ZUBA-projects/MINISUMO_ROBOT/README.md

# MINISUMO_ROBOT_EDU1

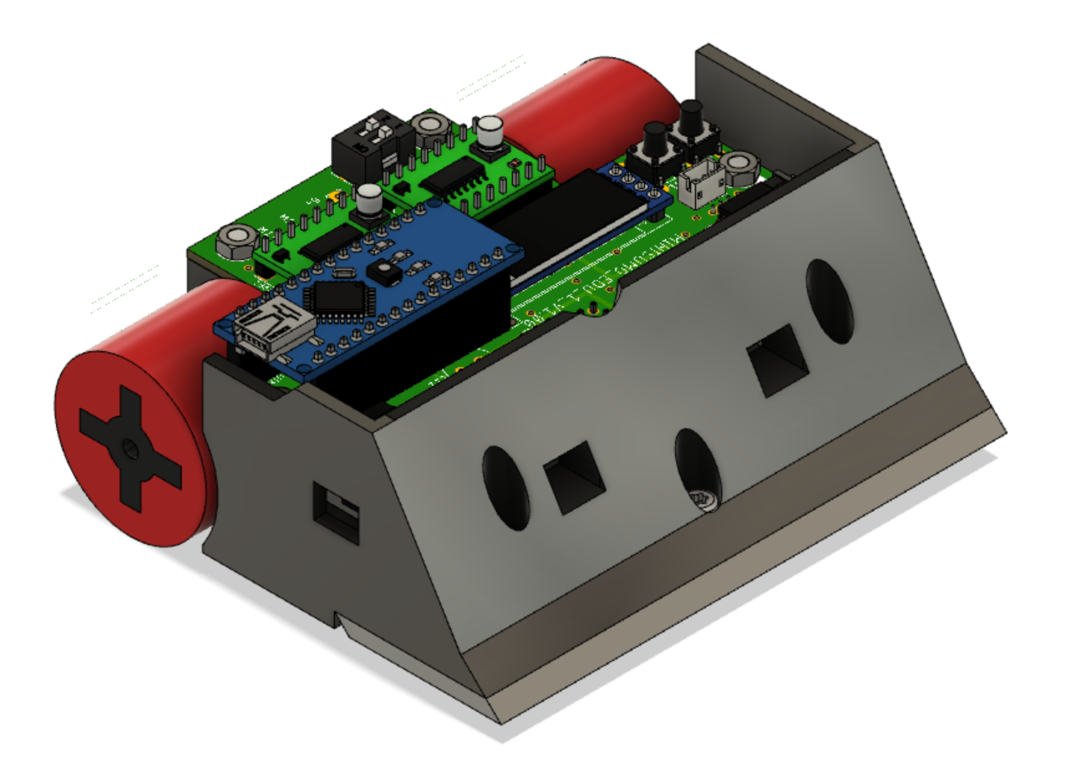
[picture p1: Minisumo_EDU_1/3D_projects/3D_EDU1_V1/MINISUMO_EDU_1.png]
Minisumo_EDU_1


Minisumo_EDU_1_done
