ZUBA-projects/MINISUMO_ROBOT/Minisumo_EDU_1/README.md

# MINISUMO_ROBOT_EDU1

Minisumo_EDU_1

There is project of Minisumo robot EDU1. 
There is two versions of hardware and 3D designs. Old one has some bugs. 
Version 2 of PCB and 3D files is fixed. Please base on fusion 360 files. 
Current design may contain bugs, errors and gluten. 

```
Hardware    -Eagle project files of hardware 
Software    -Software files (code sources)
3D_project  -Fusion360 3D project and STL files to print 
```

Assembly video PCB version 1.00, 3D design V1: https://www.youtube.com/watch?v=iEzcPpjPMYo

<object width="425" height="350">
  <param name="movie" value="https://www.youtube.com/watch?v=iEzcPpjPMYo" />
  <param name="wmode" value="transparent" />
  <embed src="https://www.youtube.com/watch?v=iEzcPpjPMYo"
         type="application/x-shockwave-flash"
         wmode="transparent" width="425" height="350" />
</object>

Minisumo_EDU_1
Minisumo_EDU_1
Minisumo_EDU_1
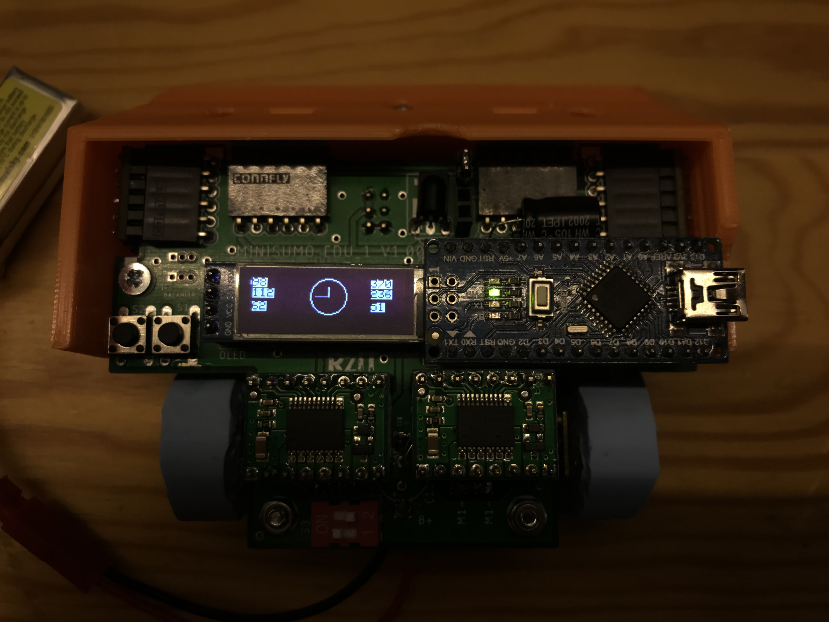
[picture p2: Minisumo_EDU_1/3D_projects/3D_EDU1_V1/Photo_7.jpg]
Minisumo_EDU_1

Minisumo_EDU_1
Minisumo_EDU_1

Enjoy!
