ZUBA-projects/MINISUMO_ROBOT/Minisumo_EDU_1/PCB_projects/README.md

# MINISUMO_ROBOT_EDU1

Mainboard rev 1.10
	
```
	//in future
```

Mainboard rev 1.00

```
Bugs: 
	-bad JST balancer connector size
	-bad color sensor connector pinout
```

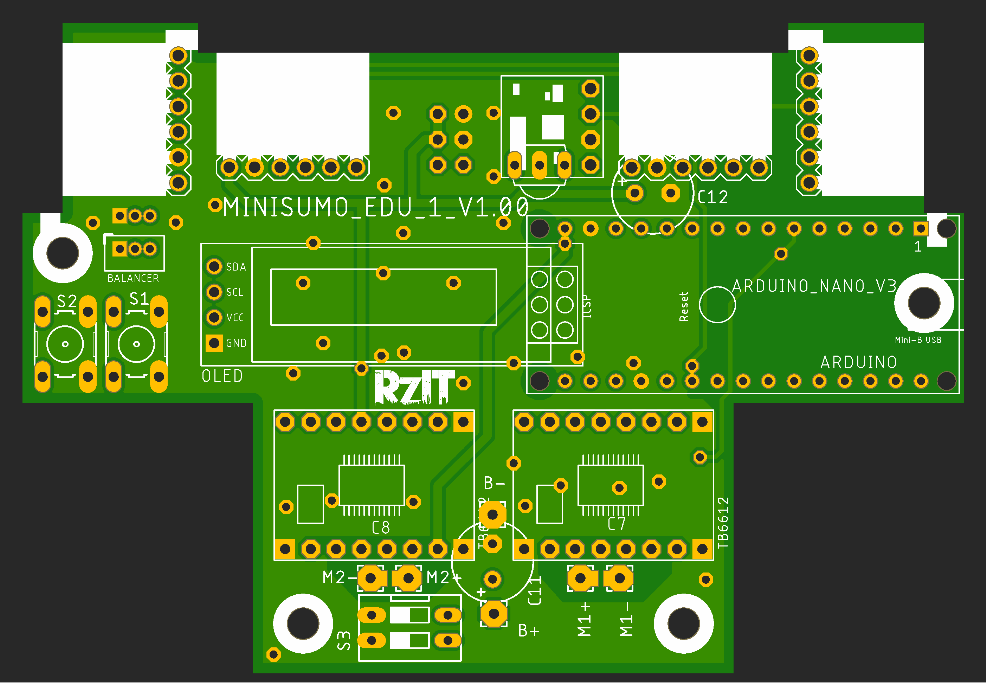
[picture p3: Minisumo_EDU_1/PCB_projects/PCB_Rev_1.00/Photo_0.png]
Minisumo_EDU_1

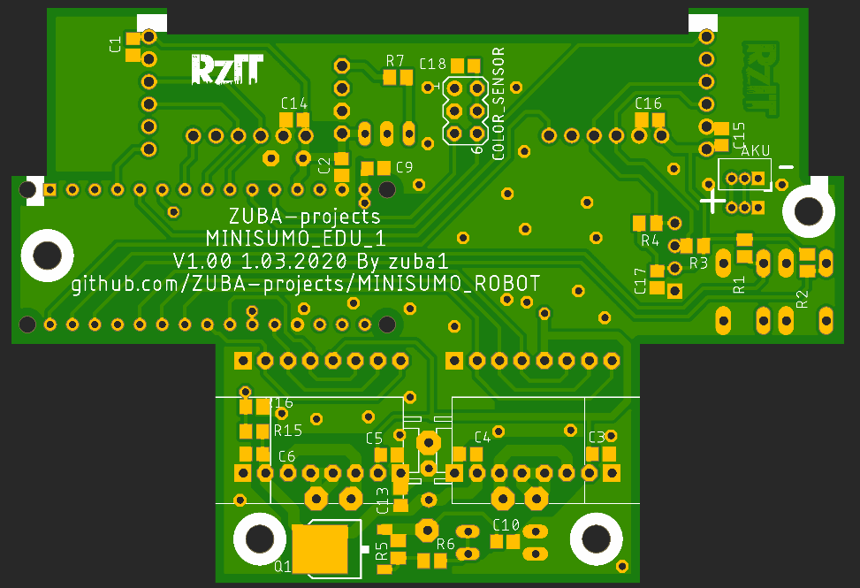
[picture p4: Minisumo_EDU_1/PCB_projects/PCB_Rev_1.00/Photo_1.png]
Minisumo_EDU_1


Eagle libraries file: https://github.com/ZUBA-projects/ZUBA_EAGLE_LBR
