ZUBA-projects/MINISUMO_ROBOT/Minisumo_EDU_1/3D_projects/README.md

# MINISUMO_ROBOT_EDU1

3D design files. Stl, Fusion files and photos of final minisumo robot.
Use EDU1_V2 files.

```
3D_EDU1_V1   -First version of robot 3D design. Contains some mechanical bugs
3D_EDU1_V2   -Second version of robot 3D design. Fixed mechanical bugs. (recommended)
3D_WHEEL_V1  -3d Model files of wheel. First version- not tested yet 
```

EDU1_V2 (recommended) 3d model:

EDU1_V1 (old) 3d model:

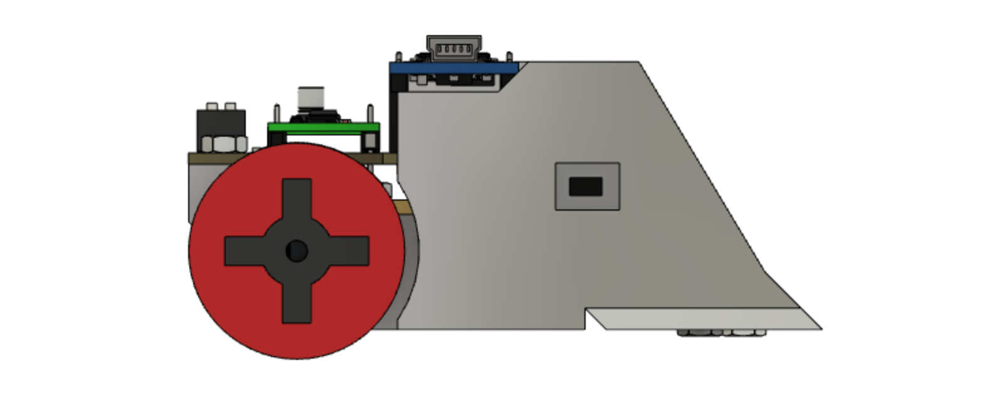
[picture p5: Minisumo_EDU_1/3D_projects/3D_EDU1_V1/Photo_1.png]
Minisumo_EDU_1

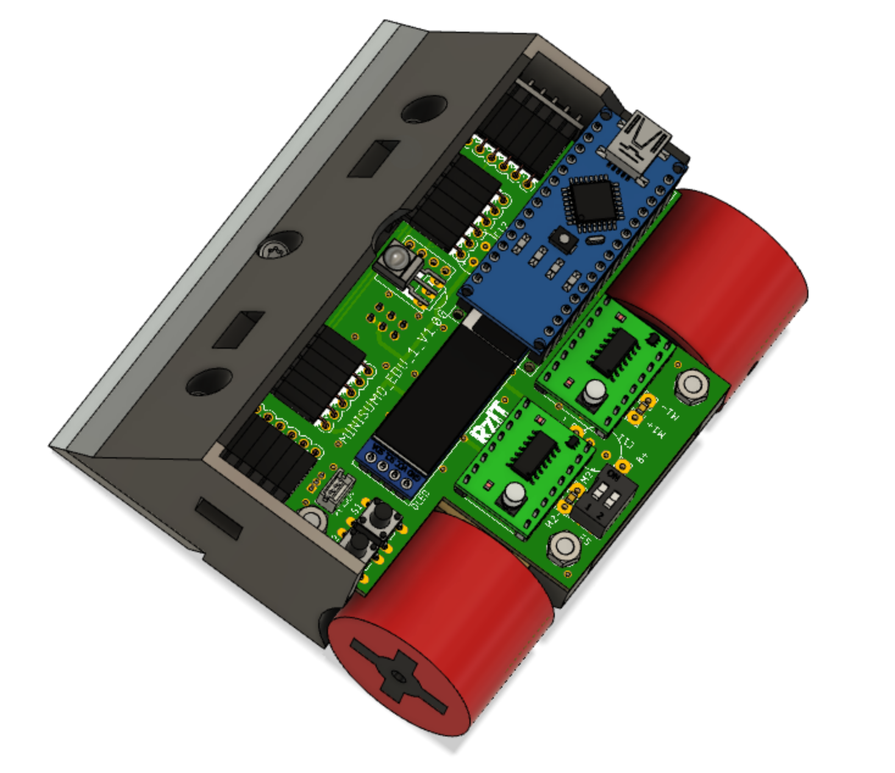
[picture p6: Minisumo_EDU_1/3D_projects/3D_EDU1_V1/Photo_2.png]
Minisumo_EDU_1

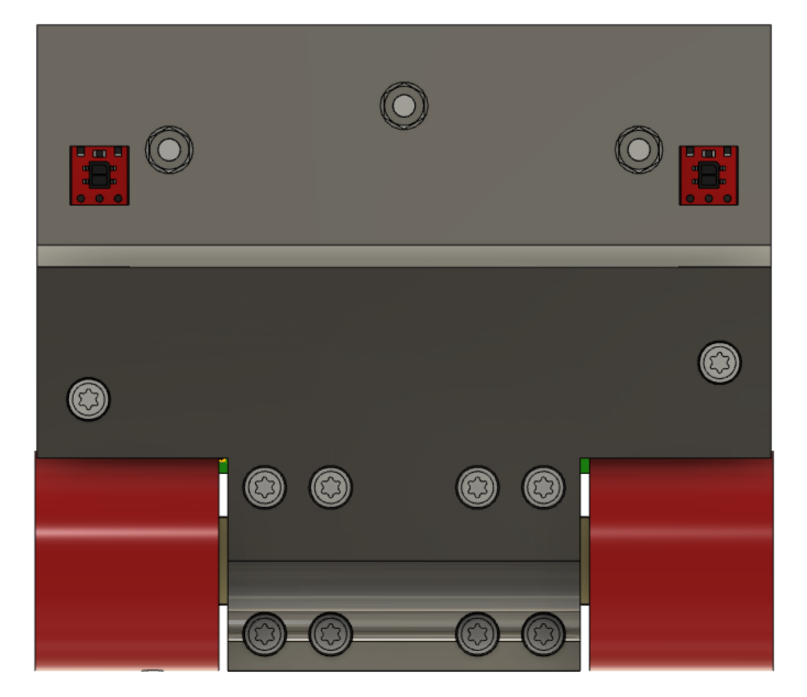
[picture p7: Minisumo_EDU_1/3D_projects/3D_EDU1_V1/Photo_3.png]
Minisumo_EDU_1

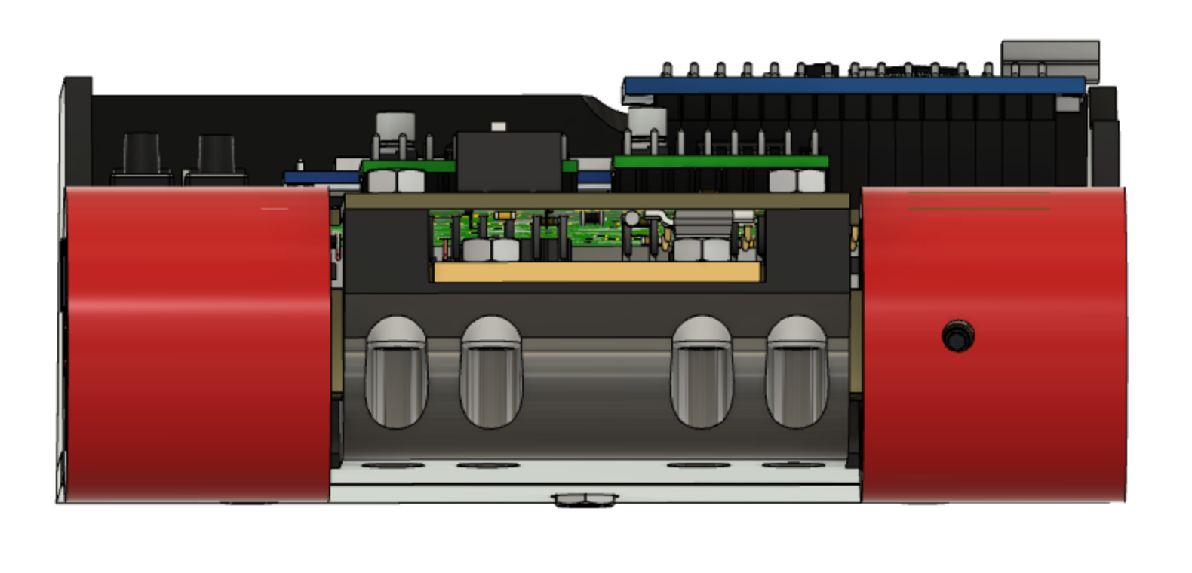
[picture p8: Minisumo_EDU_1/3D_projects/3D_EDU1_V1/Photo_4.png]
Minisumo_EDU_1


Create your own silicone Tire V1 step by step (video in future):

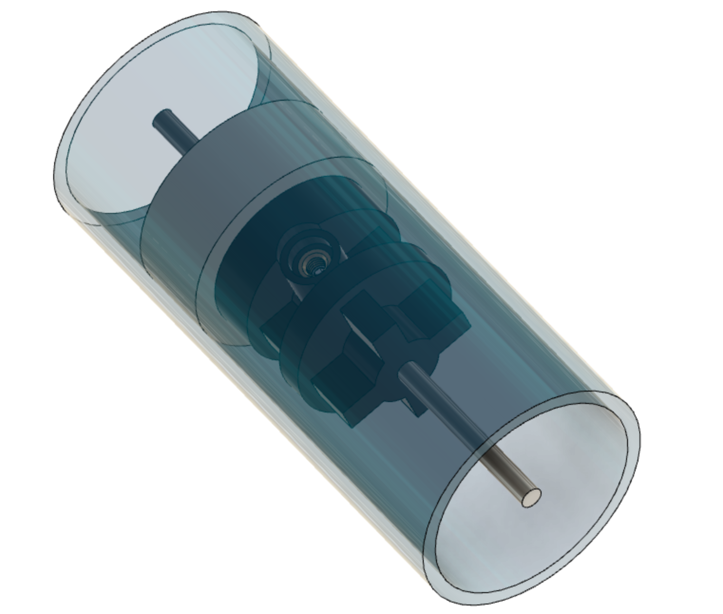
[picture p9: Minisumo_EDU_1/3D_projects/3D_WHEEL_V1/Photo_0.png]
Minisumo_EDU_1

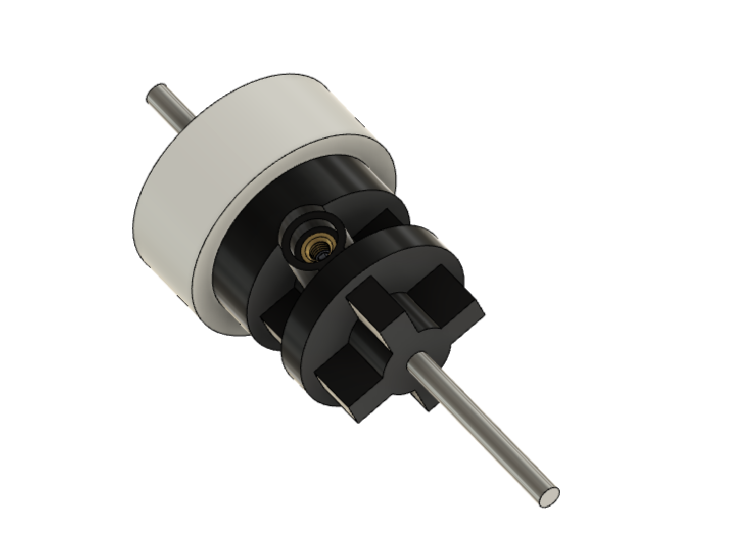
[picture p10: Minisumo_EDU_1/3D_projects/3D_WHEEL_V1/Photo_1.png]
Minisumo_EDU_1

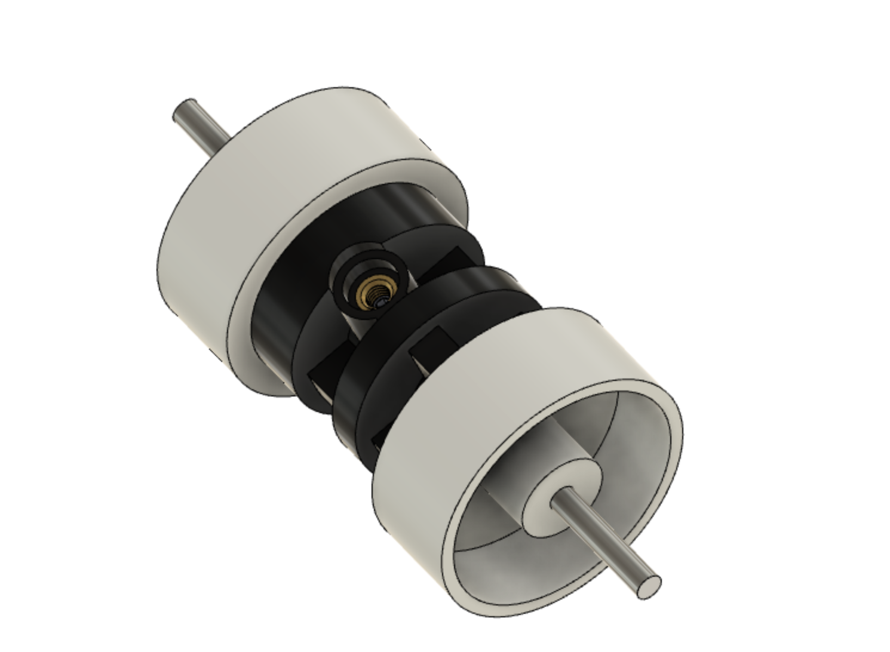
[picture p11: Minisumo_EDU_1/3D_projects/3D_WHEEL_V1/Photo_2.png]
Minisumo_EDU_1

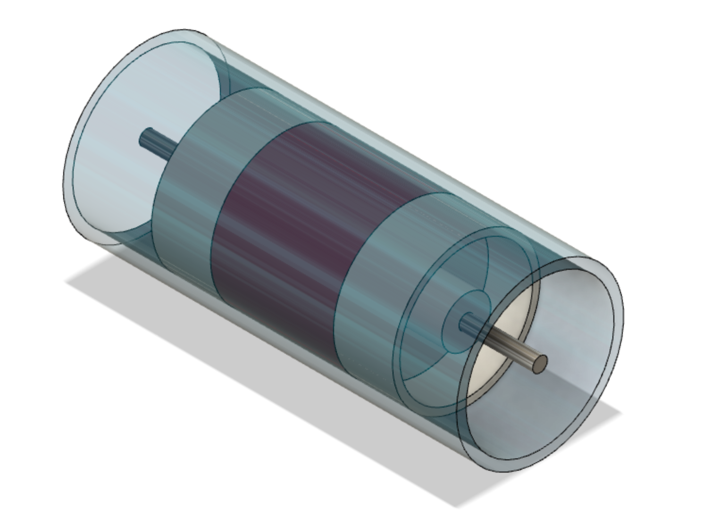
[picture p12: Minisumo_EDU_1/3D_projects/3D_WHEEL_V1/Photo_3.png]
Minisumo_EDU_1
