ZUBA-projects/MINISUMO_ROBOT/Minisumo_EDU_1/Software/README.md

# MINISUMO_ROBOT_EDU1 Software

This software is compatible witch all of main boards versions for EDU_1 robot. Right now the software is not finished yet. There is two versions of software. The miniOS will be supported by Arduino in future. 

Current version: 0.32

```
Arduino_example  -an example for test your hardware connection- Not finished, no longer supported.
Minisumo_EDU1    -miniOS HAL software port (OS designed for Minisumo robot) -still in development.
```
