ZUBA-projects/MINISUMO_ROBOT/Minisumo_EDU_1/PCB_projects/PCB_Rev_1.00/Minisumo_EDU_1_BOM.xlsx

Sheet: Mainboard_And_Sensors
Main board:
Qty | Value | Parts | Package | LINKS | Price for one | Price[PLN]
1 | 100R | R6 | M0805 | https://www.tme.eu/pl/details/smd0805-100r/rezystory-smd-0805/royal-ohm/0805s8j0101t5e/ | 0.05 | 0.05
1 | 1K | R16 | M0805 | https://www.tme.eu/pl/details/smd0805-1k/rezystory-smd-0805/royal-ohm/0805s8j0102t5e/ | 0.05 | 0.05
2 | 4K7 | R3, R4 | M0805 | https://www.tme.eu/pl/details/smd0805-4k7/rezystory-smd-0805/royal-ohm/0805s8j0472t5e/ | 0.05 | 0.1
4 | 10K | R1, R2, R5, R15 | M0805 | https://www.tme.eu/pl/details/crcw080510k0fktabc/rezystory-smd-0805/vishay/ | 0.05 | 0.2
16 | 100nF | C1, C2, C3, C4, C5, C6, C7, C8, C9, C10, C13, C14, C15, C16, C17, C18 | C0805 | https://www.tme.eu/pl/details/cl21b104kbcnnnc/kondensatory-mlcc-smd-0805/samsung/ | 0.084 | 1.344
2 | 47uF | C11, C12 | E3,5-8 | https://www.tme.eu/pl/details/ce-47_50pht/kondensatory-elektrolityczne-tht-105degc/samwha/rd1h476m6l011bb/ | 0.307 | 0.614
1 | IRFR5305 or similar | Q1 | D-PAK_TO252AA | https://www.tme.eu/pl/details/std46p4llf6/tranzystory-z-kanalem-p-smd/stmicroelectronics/ | 3.8 | 3.8
1 | TSOP4838 | U$2 | TSOP | https://www.tme.eu/pl/details/tsop4838/moduly-odbiorcze-ir/vishay/ | 2.21 | 2.21
1 | START_MODULE | U$12 | START_MODULE | https://p1r.se/startmodule/ | 0 | 0 | use this module if TSOP4838 is not used
1 | power switch | S3 | DS-02 | https://www.tme.eu/pl/details/ds-02/przelaczniki-typu-dip-switch/ninigi/ | 2.16 | 2.16
2 | function switch | S1, S2 | B3F-10XX | https://www.tme.eu/pl/details/evqpac09k/mikroprzelaczniki-tact/panasonic/ | 0.63 | 1.26
2 | JST_ZH_3 | AKU, BALANCER | JST_ZH_3 | https://www.tme.eu/pl/details/b3b-ph-k-s/zlacza-sygnalowe-raster-2-00mm/jst/ | 0.6 | 1.2
4 | VL53L0XCJ_2 | U$1, U$3, U$8, U$9 | Only Connector | https://www.tme.eu/pl/details/zl263-6sg/listwy-i-gniazda-kolkowe/connfly/ds1024-1-6rf1/ | 0.6 | 2.4
4 | VL53L0XCJ_2 | U$1, U$3, U$8, U$9 | VL53L0X_4 | http://pl.aliexpress.com/item/4000163323280.html | 13 | 52
4 | TB6612POLOLU | U$4, U$5 | Only Connector | https://www.tme.eu/pl/details/zl262-8sg/listwy-i-gniazda-kolkowe/connfly/ds1023-1-8s21/ | 0.35 | 1.4
2 | TB6612POLOLU | U$4, U$5 | POLOLU | https://www.tme.eu/pl/details/pololu-713/modulowe-sterowniki-silnikow/pololu/ | 16.43 | 32.86
1 | Color sensor conn | COLOR_SENSOR | MA03-2 | https://www.tme.eu/pl/details/pololu-2458/czujniki-odleglosci/pololu/qtr-1a-reflectance-sensor/ | 15.61 | 15.61
2 | ARDUINO_NANO_V3 | ARDUINO | Only Connector | https://www.tme.eu/pl/details/zl262-16sg/listwy-i-gniazda-kolkowe/connfly/ds1023-1-16s21/ | 0.72 | 1.44
1 | ARDUINO_NANO_V3 | ARDUINO | ARDUINO_NANO_V3 | http://pl.aliexpress.com/item/32323945639.html | 10 | 10
1 | OLED_128X32 | OLED | OLED | http://pl.aliexpress.com/item/32661842518.html | 6.42 | 6.42
1 | aku connector | B+ B- | LiPol connector | https://abc-rc.pl/product-pol-692-Wtyk-JST-BEC-z-przewodem-zenski-110mm-female.html | 1 | 1
1 | PCB | PCB |  |  | 10 | 10
 |  |  |  | price: |  | 146.118
and create charging cable:
 |  |  |  | https://www.tme.eu/pl/details/phr-3/zlacza-sygnalowe-raster-2-00mm/jst/
 |  |  |  | https://www.tme.eu/pl/details/sph-002t-p0.5s/zlacza-sygnalowe-raster-2-00mm/jst/

Sheet: Mechanical
Qty | Value | LINKS | Price[PLN]
1 | M3x6 | https://allegro.pl/oferta/sruba-kulista-m3-x-6-mm-m3x6-imbus-5-szt-7290781504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 | 2.13
4 | M3x8 | https://allegro.pl/oferta/metalowa-sruba-ampulowa-din-912-8-8-m3x8mm-10szt-7384599853 | 1.2
6 | M3x15 | https://allegro.pl/oferta/sruba-kulista-m3-x-16-mm-m3x16-imbus-5-szt-8518838451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 | 2.56
2 | M3x25 | https://allegro.pl/oferta/sruba-kulista-m3-x-25-mm-m3x25-imbus-5-szt-8844405132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 | 2.45
1 | Silicone | https://allegro.pl/oferta/profesjonalny-silikon-do-form-mm922-0-25kg-polecam-6730393238 | 28
1 | ALUMINIUM 2mm |  | 5
2 | INSERT 3mm | https://allegro.pl/oferta/insert-gwintowany-m3-7772653476 | 4
3 | SCREW M3 | https://allegro.pl/oferta/m3-x-5mm-sruba-dociskowa-imbusowa-bez-lba-e8950-8910342394 | 2
2 | POLOLU 30:1 MP or HP (or use N20) | https://allegro.pl/oferta/silnik-pololu-mp-30-1-8605570005 | 140
1 | KNIFE | https://allegro.pl/oferta/noz-do-strugarki-noze-heblarki-ds-ncv1-410x30x3-5894552908 | 34
 |  | Price: | 221.34

Sheet: TOTAL
Robot:
Qty | Link | Price[PLN]
Main Board And Sensors |  | 146.118
Mechanical |  | 221.34
Lipol 500mAh 7,4V JST | https://allegro.pl/oferta/bateria-li-po-7-4v-2s-500mah-20c-turnigy-rc-7442301257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 | 38
price: |  | 405.458
Aditional Cost:
Qty | Link | Price[PLN]
3d Printing |  | 25
Knife Miling |  | 30
Lipol Charger | https://allegro.pl/oferta/ladowarka-mikroprocesorowa-redox-alpha-v2-combo-8395806877 | 120
Charging cable |  | 5
Price: |  | 180
TOTAL: |  | 585.458
