ZUBA-projects/MINISUMO_ROBOT/Minisumo_EDU_1/3D_projects/3D_EDU1_V1/stl_files/Minisumo_Body.stl

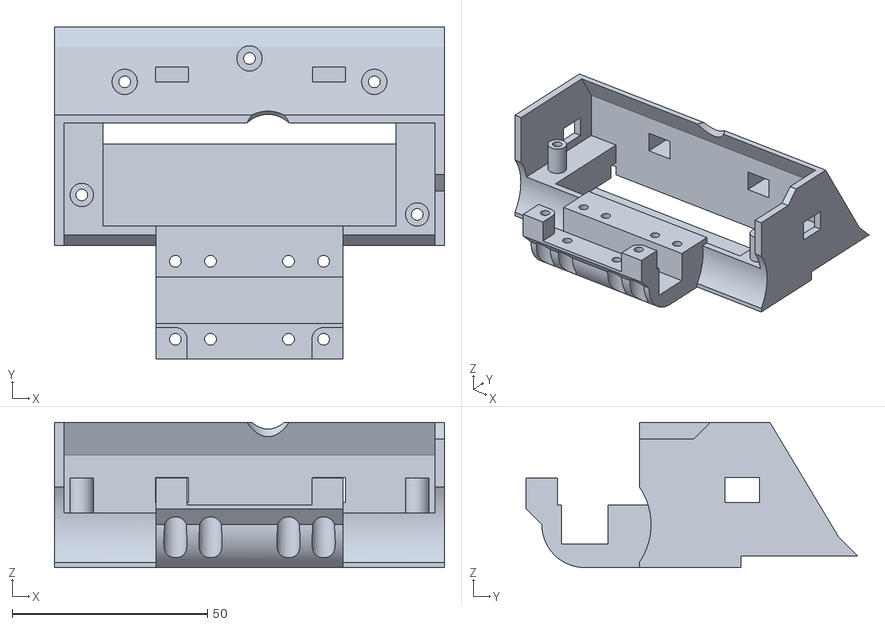
[picture p13: CAD file, 2020-03-08]
Minisumo_EDU_1/3D_projects/3D_EDU1_V1/stl_files/Minisumo_Body.stl
100.0 x 85.0 x 37.2
