ZUBA-projects/MINISUMO_ROBOT/Minisumo_EDU_1/3D_projects/3D_WHEEL_V1/stl_files/holedr_wheel.stl

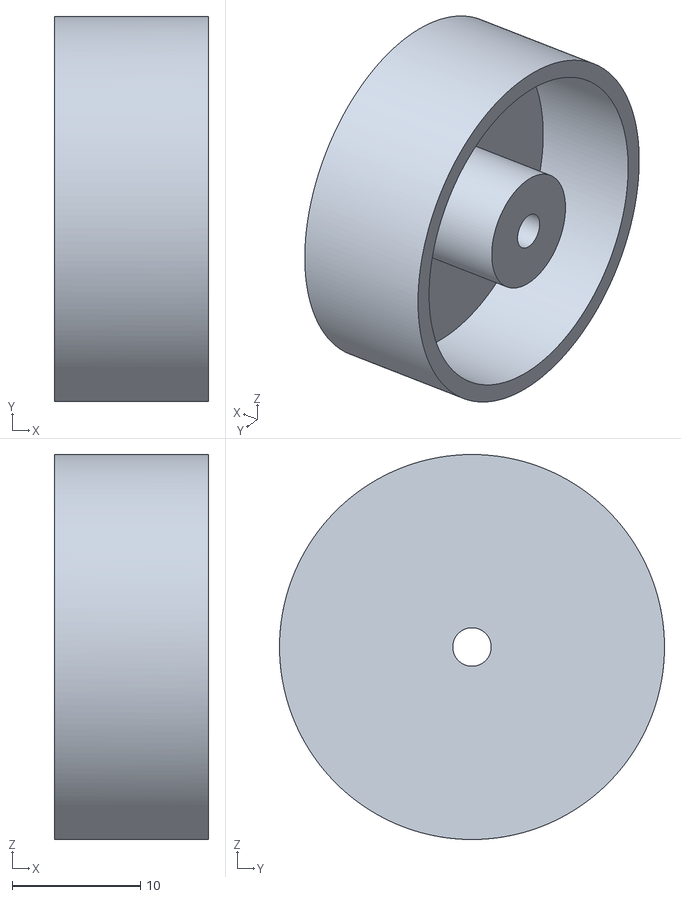
[picture p14: CAD file, 2020-03-08]
Minisumo_EDU_1/3D_projects/3D_WHEEL_V1/stl_files/holedr_wheel.stl
12.0 x 30.0 x 30.0
