ZUBA-projects/MINISUMO_ROBOT/Minisumo_EDU_1/3D_projects/3D_WHEEL_V1/stl_files/wheel.stl

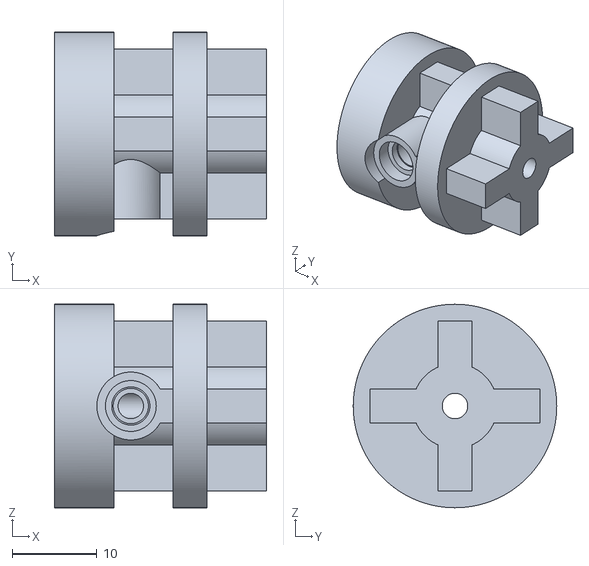
[picture p15: CAD file, 2020-03-08]
Minisumo_EDU_1/3D_projects/3D_WHEEL_V1/stl_files/wheel.stl
25.0 x 24.0 x 24.0
