ZUBA-projects/MINISUMO_ROBOT/(list of files, cad)

Other CAD files:
Minisumo_EDU_1/3D_projects/3D_WHEEL_V1/Wheel_30x25.f3d
