ZUBA-projects/MINISUMO_ROBOT/Minisumo_EDU_1/PCB_projects/PCB_Rev_1.00/main.pdf

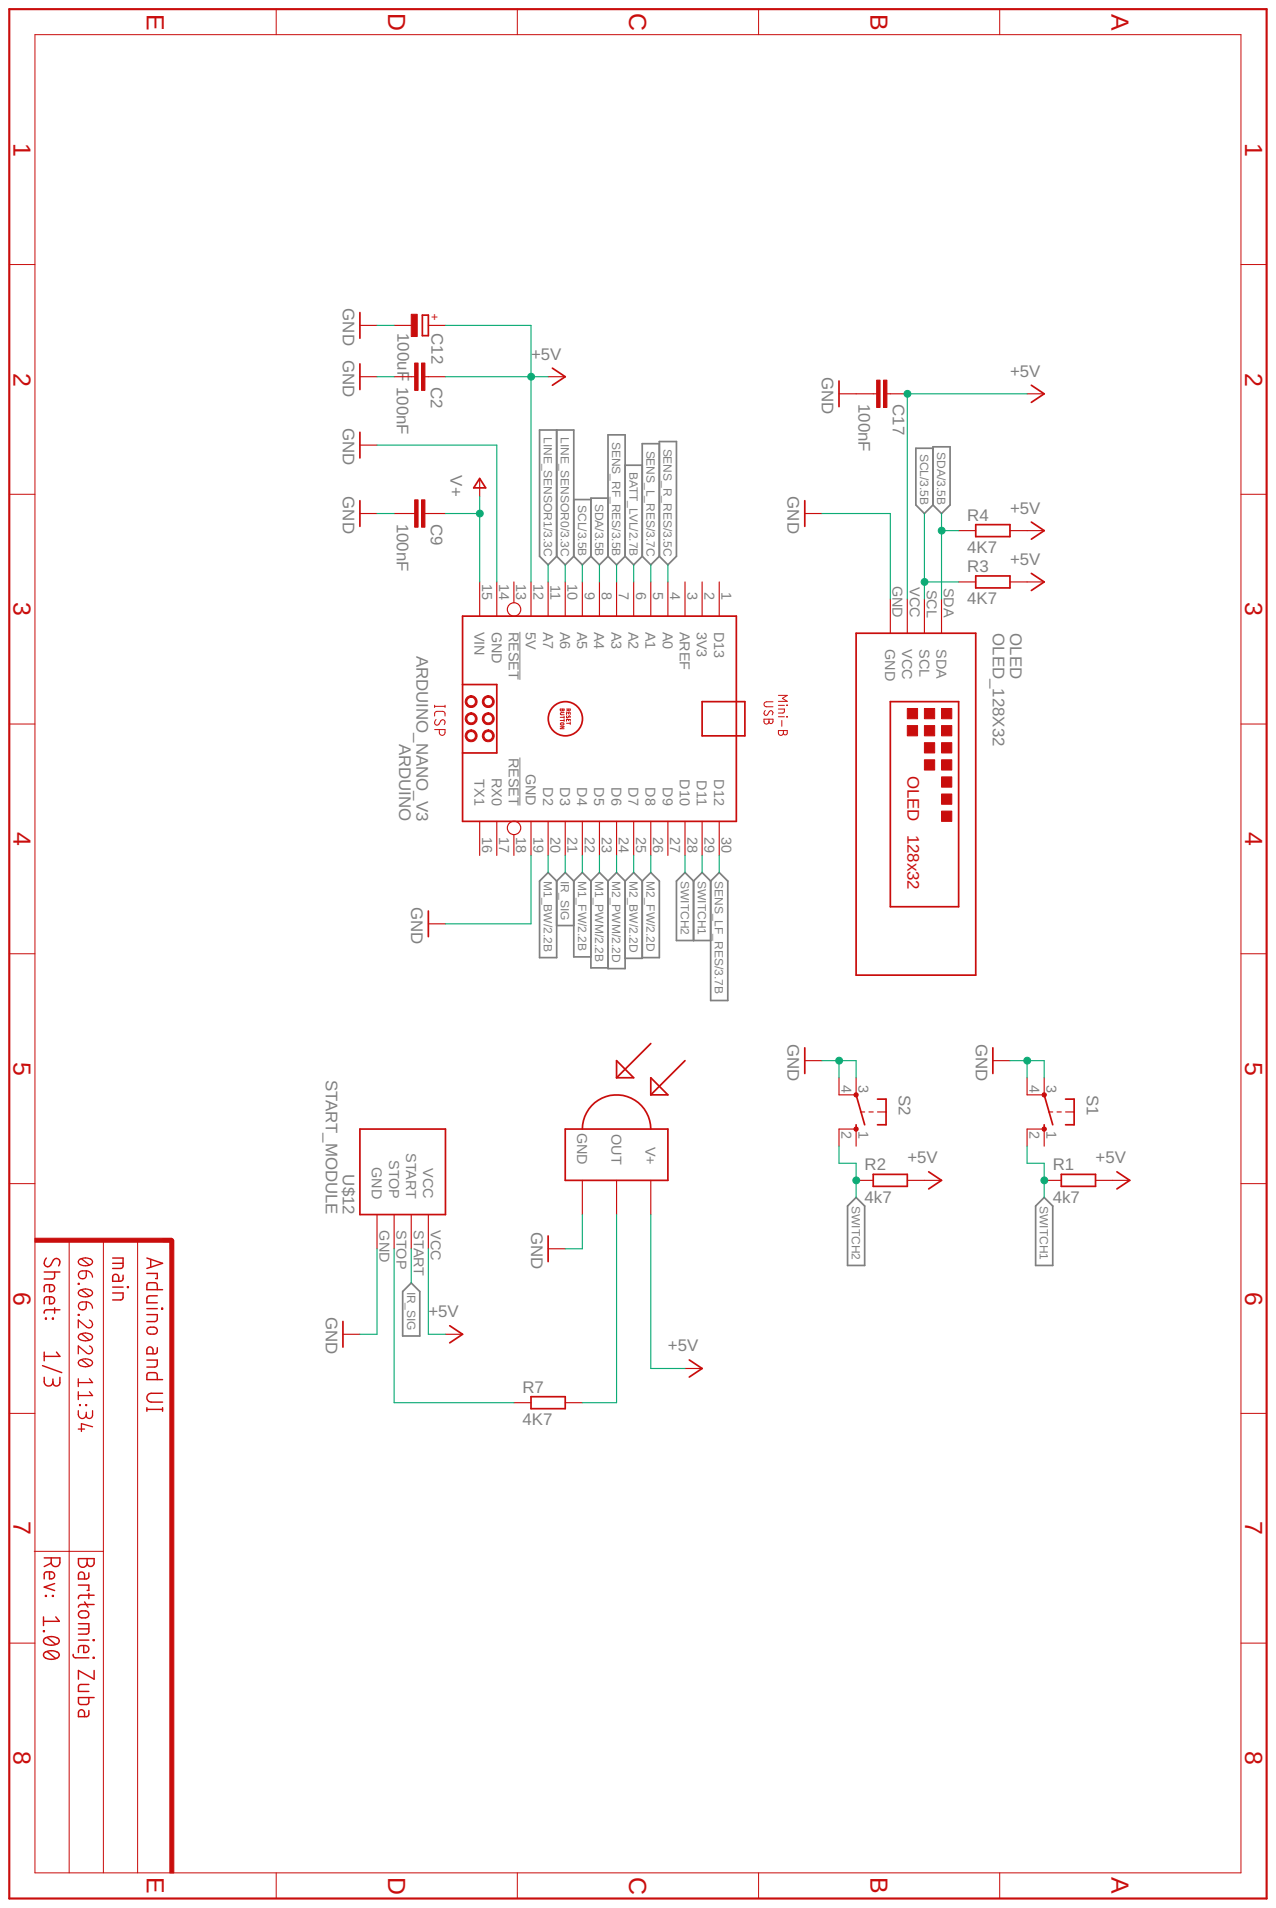
[picture p16: page 1]

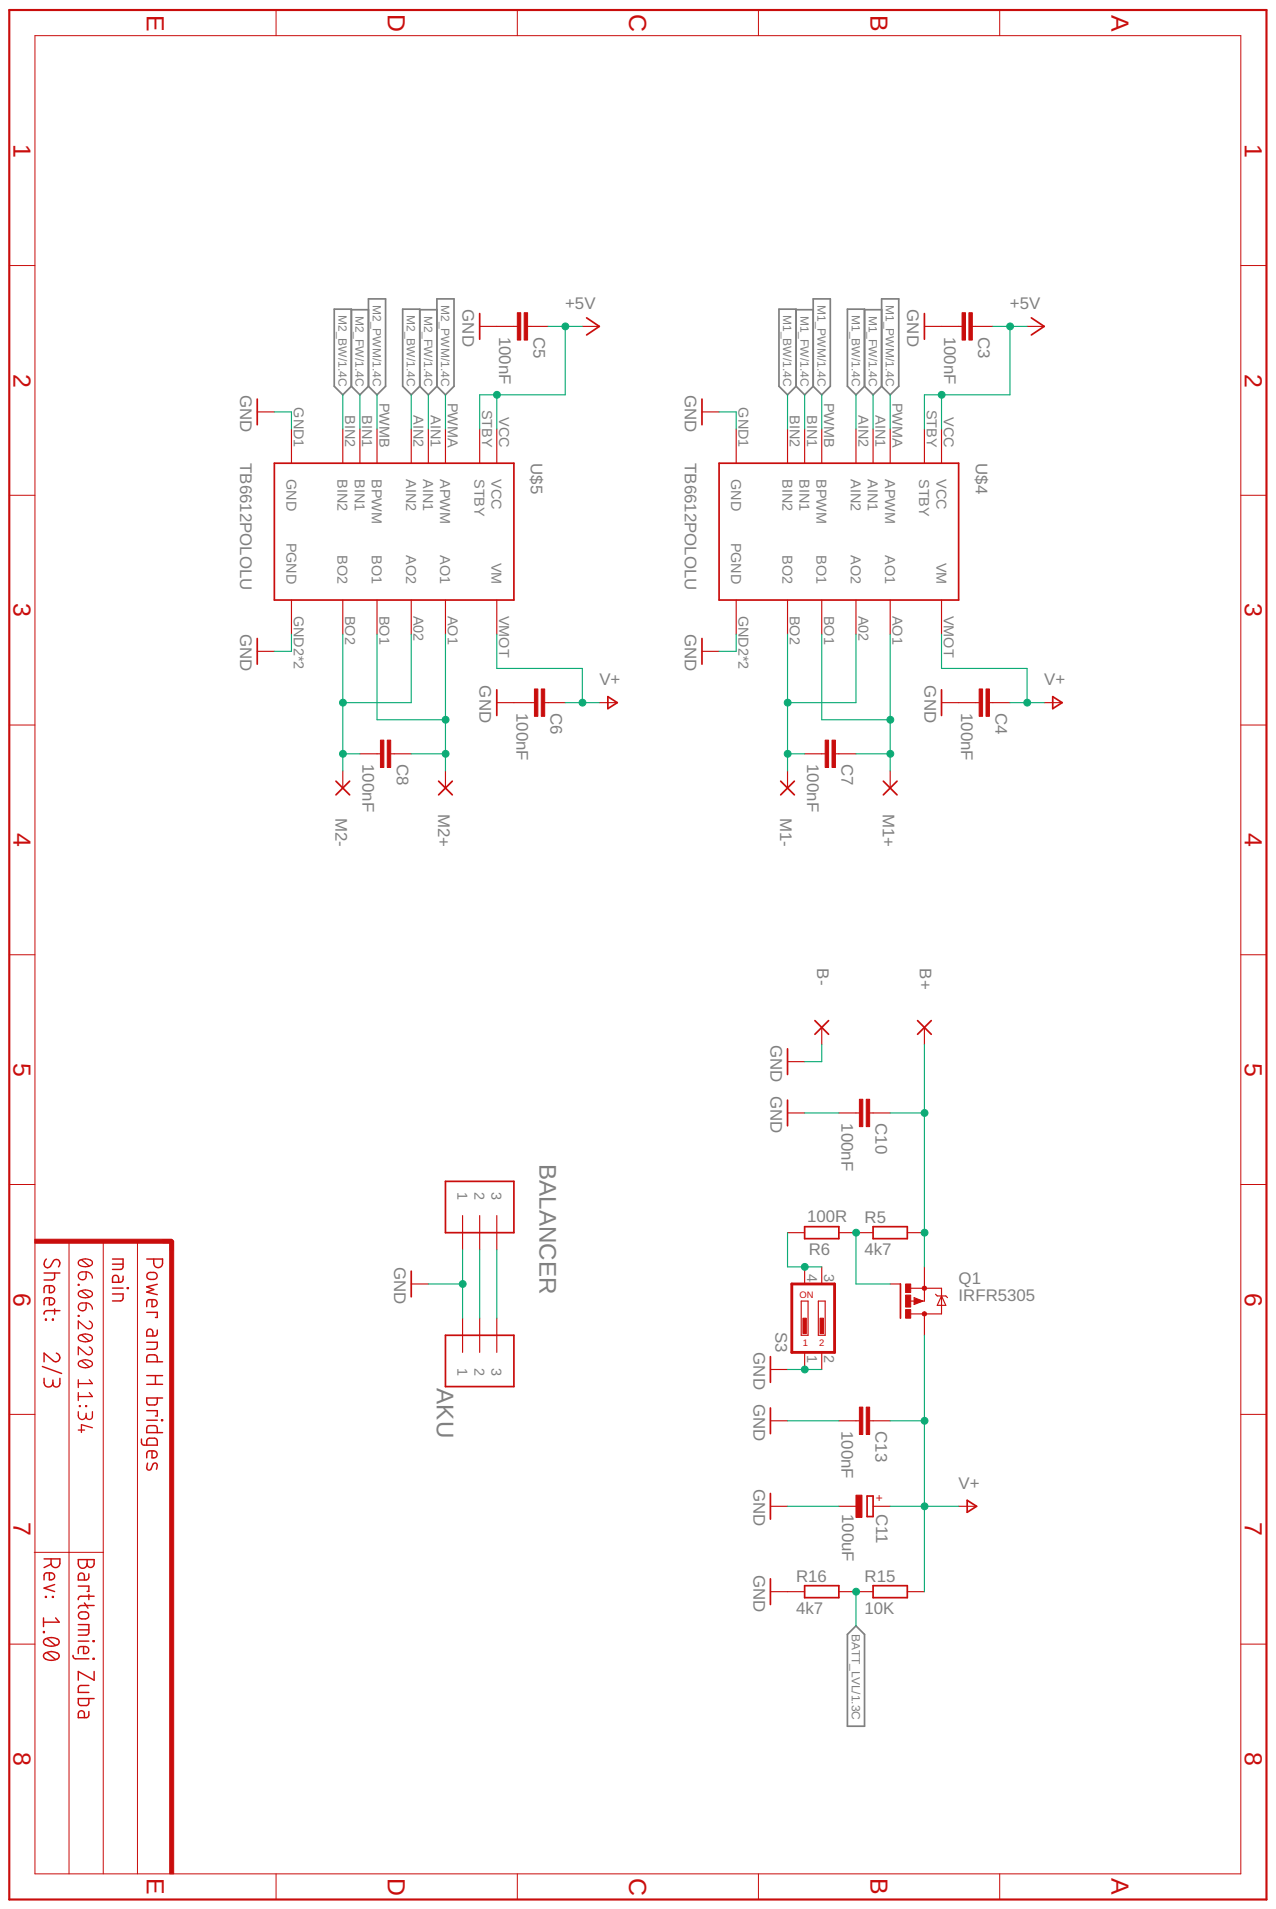
[picture p17: page 2]

TB6612POLOLU TB6612POLOLU 100nF 100nF 100nF 100nF 100nF 100nF GND GND GND V+ G+5V ND GND GND GND GND +5V V+ 100nF GND GND 100uF V+ GND 100nF GND GND IRFR5305 4k7 100R GND 4k7 10K GND AIN2 AIN2 AIN1 AIN1 APWM PWMA BPWM PWMB BIN1 BIN1 BIN2 BIN2 GND GND1 AO1 AO1 AO2 A02 VCC VCC STBY STBY PGND GND2*2 VM VMOT BO1 BO1 BO2 BO2 U$4AIN2 AIN2 AIN1 AIN1 APWM PWMA BPWM PWMB BIN1 BIN1 BIN2 BIN2 GND GND1 AO1 AO1 AO2 A02 VCC VCC STBY STBY PGND GND2*2 VM VMOT BO1 BO1 BO2 BO2 U$5 C3 C4 C5 C6 C7 M1+ M1- C8 M2+ M2- B- B+ C10 C11 C13 Q1 R5 R6 43 12 S3 123 BALANCER 123 AKU R16 R15M1_PWM/1.4C M1_PWM/1.4C M1_FW/1.4C M1_FW/1.4C M1_BW/1.4C M1_BW/1.4C M2_PWM/1.4C M2_PWM/1.4C M2_FW/1.4C M2_FW/1.4C M2_BW/1.4C M2_BW/1.4C BATT_LVL/1.3C + 1 2 ON EDCBA 1 2 3 4 5 6 7 8 EDCBA 1 2 3 4 5 6 7 8

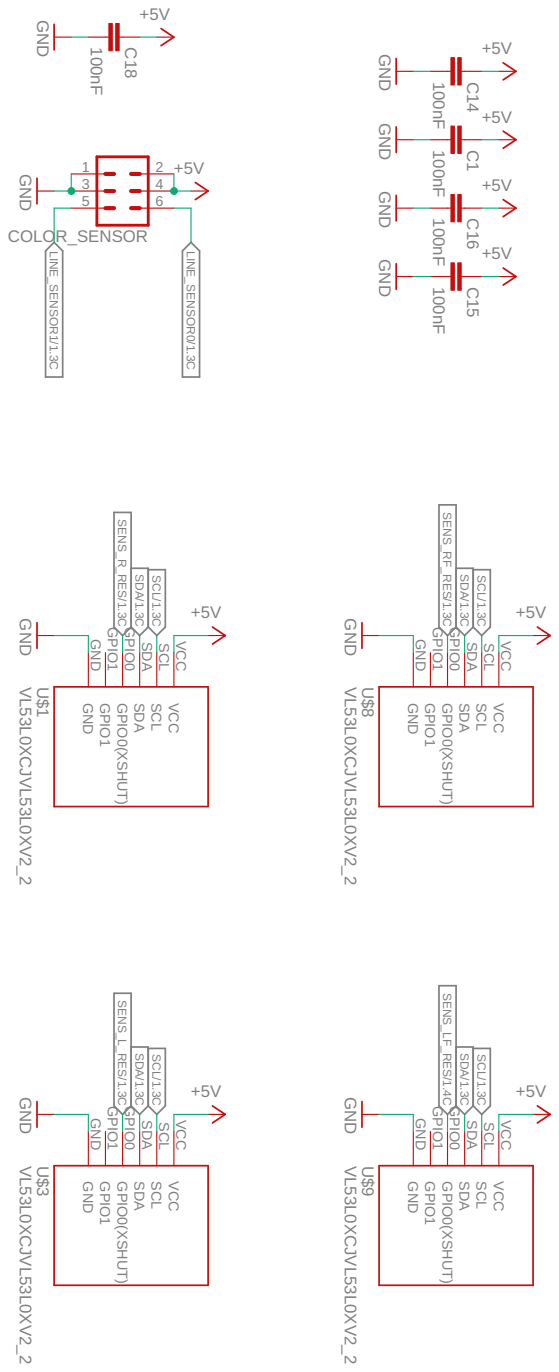
[picture p18: page 3]

VL53L0XCJVL53L0XV2_2 100nF G+5V ND G+5V ND G+5V ND G+5V ND G+5V ND 100nF G+5V ND 100nF G+5V ND 100nF G+5V ND 100nF G+5V ND G+5V ND VL53L0XCJVL53L0XV2_2 VL53L0XCJVL53L0XV2_2 VL53L0XCJVL53L0XV2_2 VCC VCC SCL SCL SDA SDA GPIO0(XSHUT) GPIO0 GPIO1 GPIO1 GND GND U$8 C15 C16 C1 C14 C18 135 246 COLOR_SENSOR VCC VCC SCL SCL SDA SDA GPIO0(XSHUT) GPIO0 GPIO1 GPIO1 GND GND U$1 VCC VCC SCL SCL SDA SDA GPIO0(XSHUT) GPIO0 GPIO1 GPIO1 GND GND U$3VCC VCC SCL SCL SDA SDA GPIO0(XSHUT) GPIO0 GPIO1 GPIO1 GND GND U$9 SCL/1.3C SCL/1.3C SCL/1.3C SCL/1.3C SDA/1.3C SDA/1.3C SDA/1.3C SDA/1.3C SENS_RF_RES/1.3C SENS_R_RES/1.3C SENS_L_RES/1.3C SENS_LF_RES/1.4C LINE_SENSOR0/1.3C LINE_SENSOR1/1.3C EDCBA 1 2 3 4 5 6 7 8 EDCBA 1 2 3 4 5 6 7 8
