ZUBA-projects/MINISUMO_ROBOT/Minisumo_EDU_1/PCB_projects/PCB_Rev_1.00/main.brd

## EAGLE design Minisumo_EDU_1/PCB_projects/PCB_Rev_1.00/main.brd (2020-06-08)

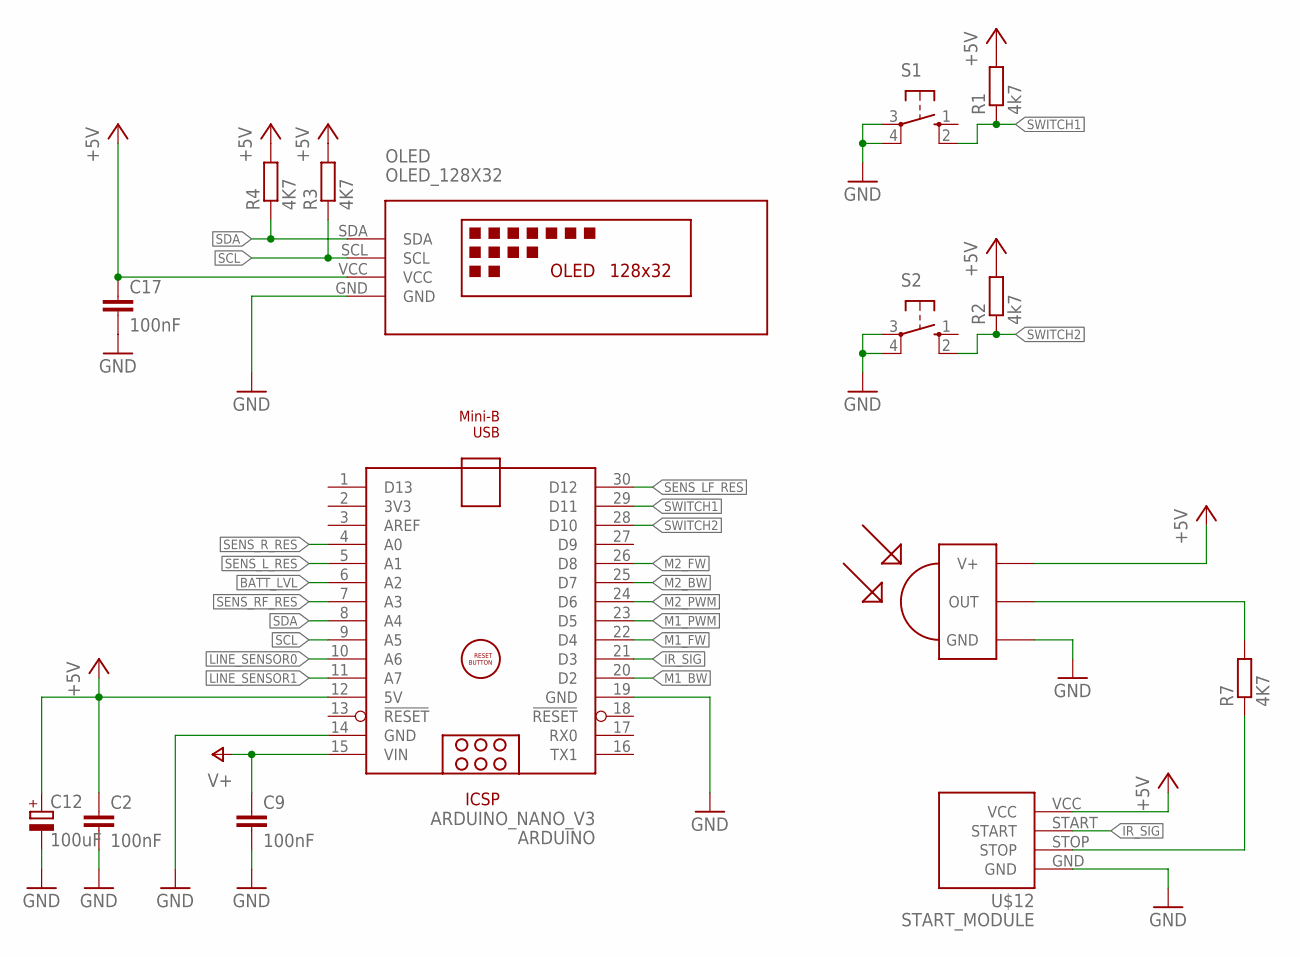
[picture p19: schematic main.sch, sheet 1, Arduino and UI]

Parts:
ARDUINO: ARDUINO_NANO_V3
C2, C9, C17: 100nF; C0805
C12: 100uF; E3,5-8
OLED: OLED_128X32; OLED
R1, R2: 4k7; M0805
R3, R4, R7: 4K7; M0805
S1, S2: 10-XX; B3F-10XX
U$2: TSOP4838; TSOP
U$12: START_MODULE

Connections:
+5V: ARDUINO.12 (5V), C2.1, C12.+, C17.1, OLED.VCC, R1.2, R2.2, R3.2, R4.2, U$2.VCC (V+), U$12.VCC; also elsewhere on the board
BATT_LVL: ARDUINO.6 (A2); also elsewhere on the board
GND: ARDUINO.14 (GND), ARDUINO.19 (GND), C2.2, C9.2, C12.-, C17.2, OLED.GND, S1.3, S1.4 (P1), S2.3, S2.4 (P1), U$2.GND, U$12.GND; also elsewhere on the board
IR_SIG: ARDUINO.21 (D3), U$12.START
LINE_SENSOR0: ARDUINO.10 (A6); also elsewhere on the board
LINE_SENSOR1: ARDUINO.11 (A7); also elsewhere on the board
M1_BW: ARDUINO.20 (D2); also elsewhere on the board
M1_FW: ARDUINO.22 (D4); also elsewhere on the board
M1_PWM: ARDUINO.23 (D5); also elsewhere on the board
M2_BW: ARDUINO.25 (D7); also elsewhere on the board
M2_FW: ARDUINO.26 (D8); also elsewhere on the board
M2_PWM: ARDUINO.24 (D6); also elsewhere on the board
unnamed: R7.1, U$12.STOP
unnamed: R7.2, U$2.OUT
SCL: ARDUINO.9 (A5), OLED.SCL, R3.1; also elsewhere on the board
SDA: ARDUINO.8 (A4), OLED.SDA, R4.1; also elsewhere on the board
SENS_LF_RES: ARDUINO.30 (D12); also elsewhere on the board
SENS_L_RES: ARDUINO.5 (A1); also elsewhere on the board
SENS_RF_RES: ARDUINO.7 (A3); also elsewhere on the board
SENS_R_RES: ARDUINO.4 (A0); also elsewhere on the board
SWITCH1: ARDUINO.29 (D11), R1.1, S1.2 (S1)
SWITCH2: ARDUINO.28 (D10), R2.1, S2.2 (S1)
V+: ARDUINO.15 (VIN), C9.1; also elsewhere on the board

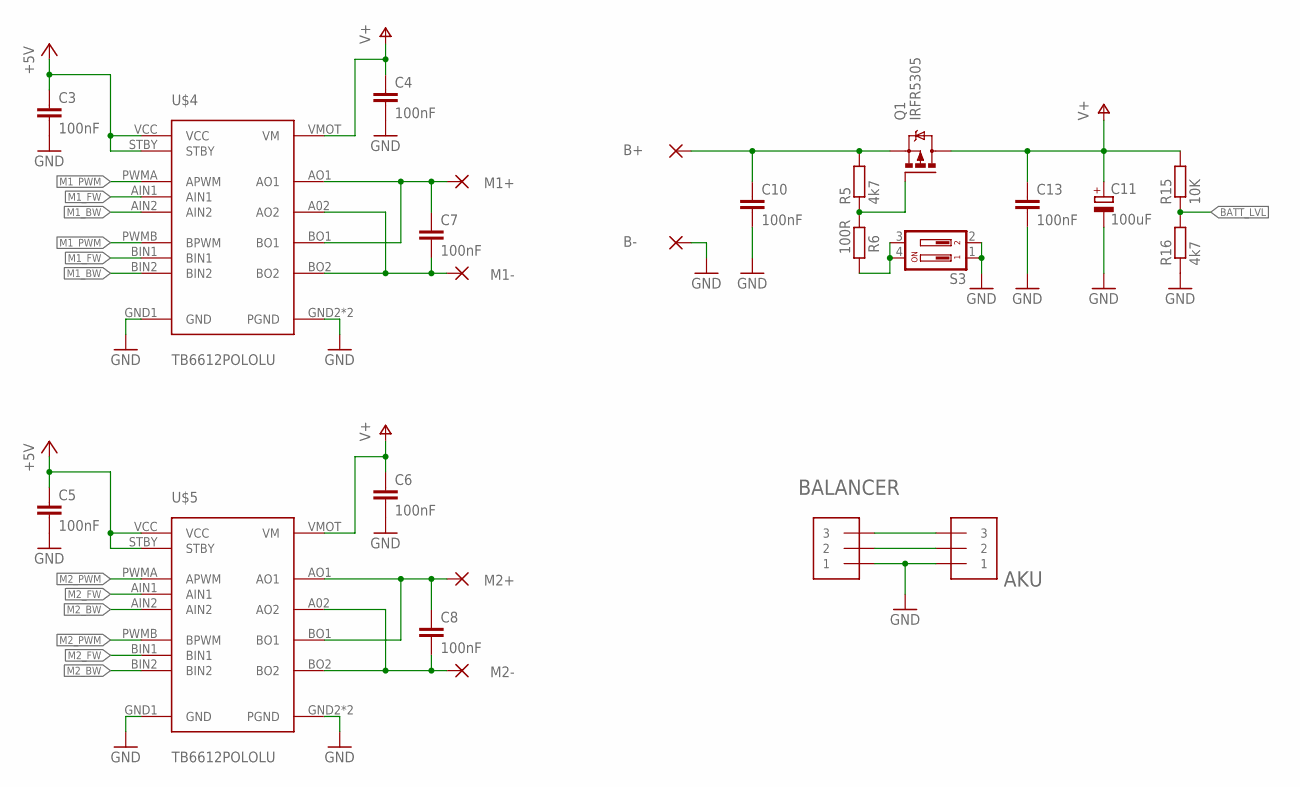
[picture p20: schematic main.sch, sheet 2, POWER AND H BRIDGES]

Parts:
AKU: JST_ZH_3
B+: 2,54/1,0
B-: 2,54/1,0
BALANCER: JST_ZH_3
C3, C4, C5, C6, C7, C8, C10, C13: 100nF; C0805
C11: 100uF; E3,5-8
M1+, M1-, M2+, M2-: 2,54/1,0
Q1: IRFR5305; D-PAK_TO252AA
R5, R16: 4k7; M0805
R6: 100R; M0805
R15: 10K; M0805
S3: DS02; DS-02
U$4, U$5: TB6612POLOLU; POLOLU

Connections:
+5V: C3.1, C5.1, U$4.STBY, U$4.VCC, U$5.STBY, U$5.VCC; also elsewhere on the board
BATT_LVL: R15.1, R16.2; also elsewhere on the board
GND: AKU.P$1 (1), B-.1, BALANCER.P$1 (1), C3.2, C4.2, C5.2, C6.2, C10.2, C11.-, C13.2, R16.1, S3.1, S3.2, U$4.GND1 (GND), U$4.GND2 (PGND), U$4.GND3 (PGND), U$5.GND1 (GND), U$5.GND2 (PGND), U$5.GND3 (PGND); also elsewhere on the board
M1_BW: U$4.AIN2, U$4.BIN2; also elsewhere on the board
M1_FW: U$4.AIN1, U$4.BIN1; also elsewhere on the board
M1_PWM: U$4.PWMA (APWM), U$4.PWMB (BPWM); also elsewhere on the board
M2_BW: U$5.AIN2, U$5.BIN2; also elsewhere on the board
M2_FW: U$5.AIN1, U$5.BIN1; also elsewhere on the board
M2_PWM: U$5.PWMA (APWM), U$5.PWMB (BPWM); also elsewhere on the board
unnamed: C7.1, M1+.1, U$4.AO1, U$4.BO1
unnamed: C7.2, M1-.1, U$4.A02 (AO2), U$4.BO2
unnamed: C8.1, M2+.1, U$5.AO1, U$5.BO1
unnamed: C8.2, M2-.1, U$5.A02 (AO2), U$5.BO2
unnamed: Q1.1 (G), R5.1, R6.1
unnamed: R6.2, S3.3, S3.4
unnamed: AKU.P$2 (2), BALANCER.P$2 (2)
unnamed: B+.1, C10.1, Q1.3 (S), R5.2
unnamed: AKU.P$3 (3), BALANCER.P$3 (3)
V+: C4.1, C6.1, C11.+, C13.1, Q1.4 (D), R15.2, U$4.VMOT (VM), U$5.VMOT (VM); also elsewhere on the board

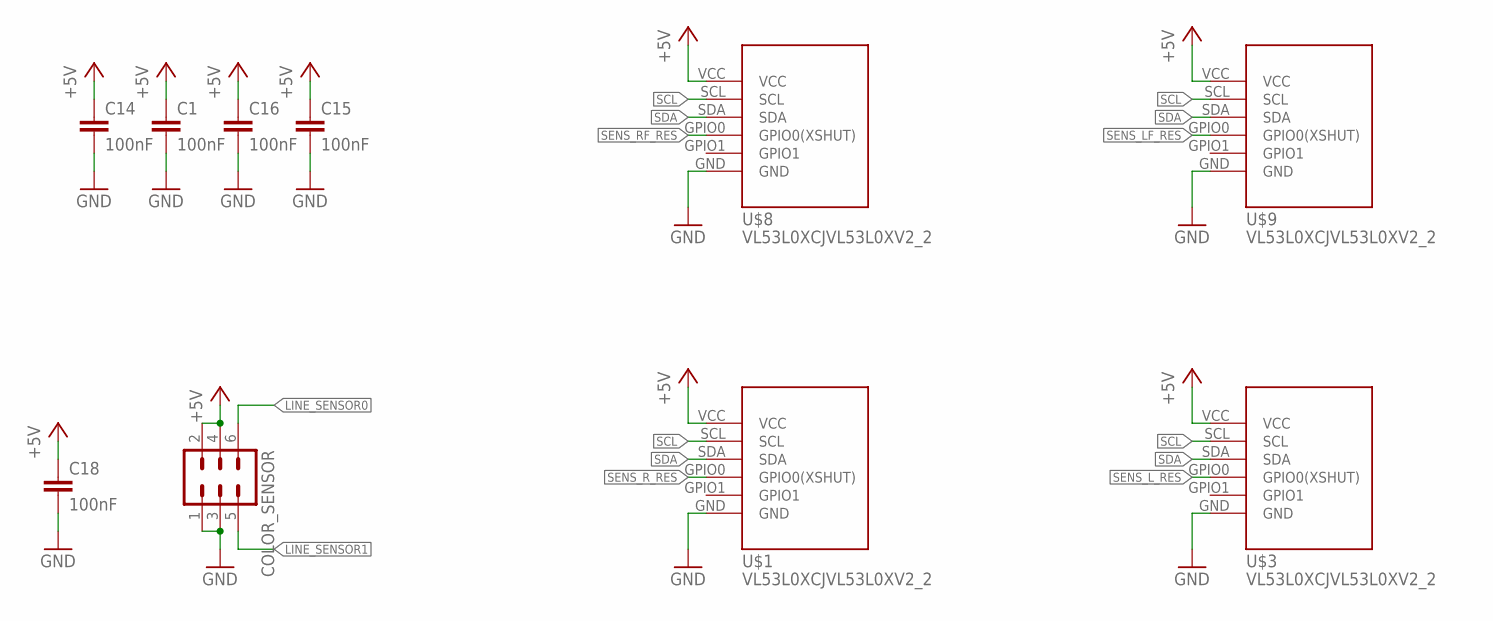
[picture p21: schematic main.sch, sheet 3, RANGE SENSORS]

Parts:
C1, C14, C15, C16, C18: 100nF; C0805
COLOR_SENSOR: MA03-2
U$1, U$3, U$8, U$9: VL53L0XCJVL53L0XV2_2; VL53L0X_4

Connections:
+5V: C1.1, C14.1, C15.1, C16.1, C18.1, COLOR_SENSOR.2, COLOR_SENSOR.4, U$1.VCC, U$3.VCC, U$8.VCC, U$9.VCC; also elsewhere on the board
GND: C1.2, C14.2, C15.2, C16.2, C18.2, COLOR_SENSOR.1, COLOR_SENSOR.3, U$1.GND, U$3.GND, U$8.GND, U$9.GND; also elsewhere on the board
LINE_SENSOR0: COLOR_SENSOR.6; also elsewhere on the board
LINE_SENSOR1: COLOR_SENSOR.5; also elsewhere on the board
SCL: U$1.SCL, U$3.SCL, U$8.SCL, U$9.SCL; also elsewhere on the board
SDA: U$1.SDA, U$3.SDA, U$8.SDA, U$9.SDA; also elsewhere on the board
SENS_LF_RES: U$9.GPIO0 (GPIO0(XSHUT)); also elsewhere on the board
SENS_L_RES: U$3.GPIO0 (GPIO0(XSHUT)); also elsewhere on the board
SENS_RF_RES: U$8.GPIO0 (GPIO0(XSHUT)); also elsewhere on the board
SENS_R_RES: U$1.GPIO0 (GPIO0(XSHUT)); also elsewhere on the board

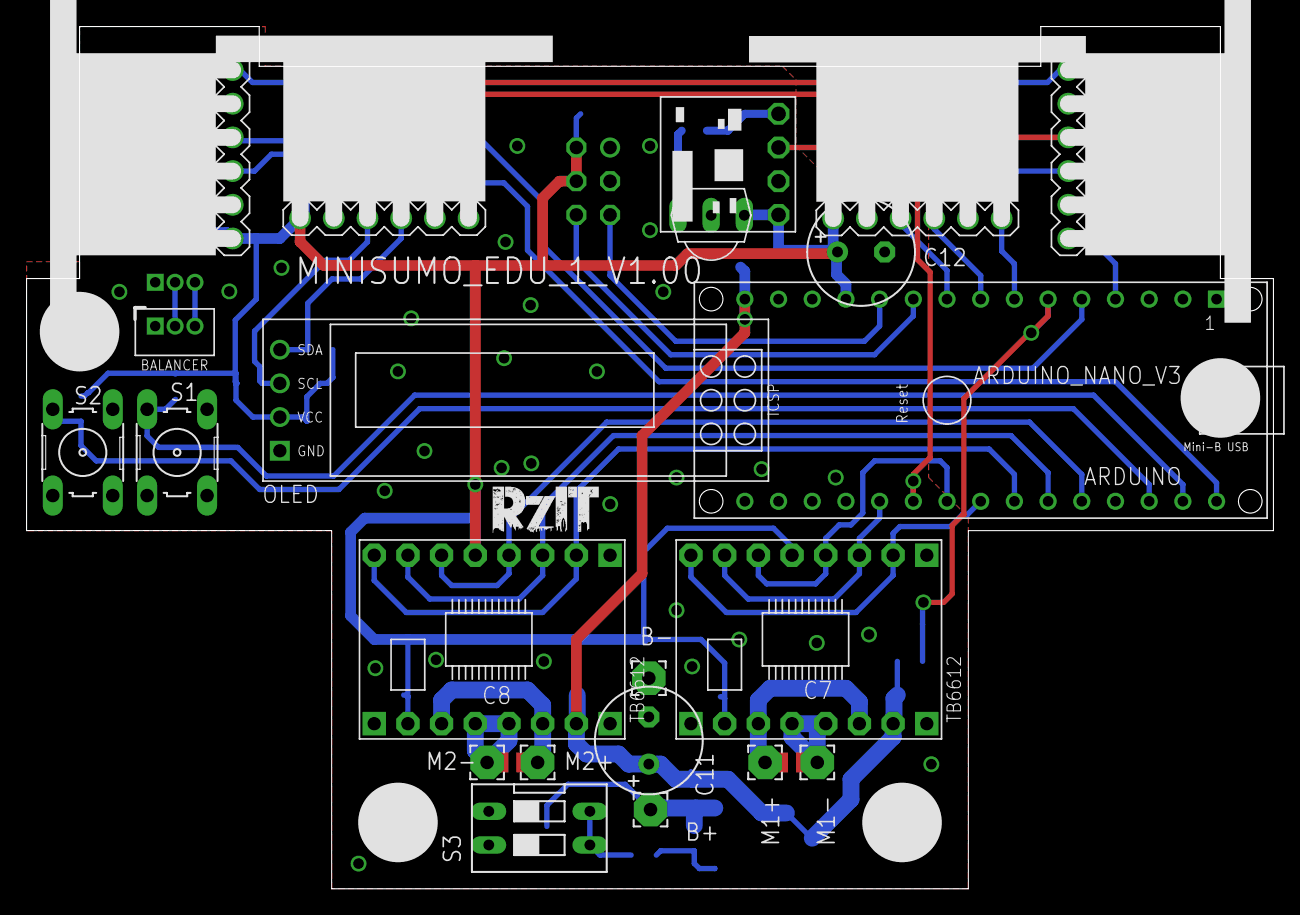
[picture p22: board main.brd from above]

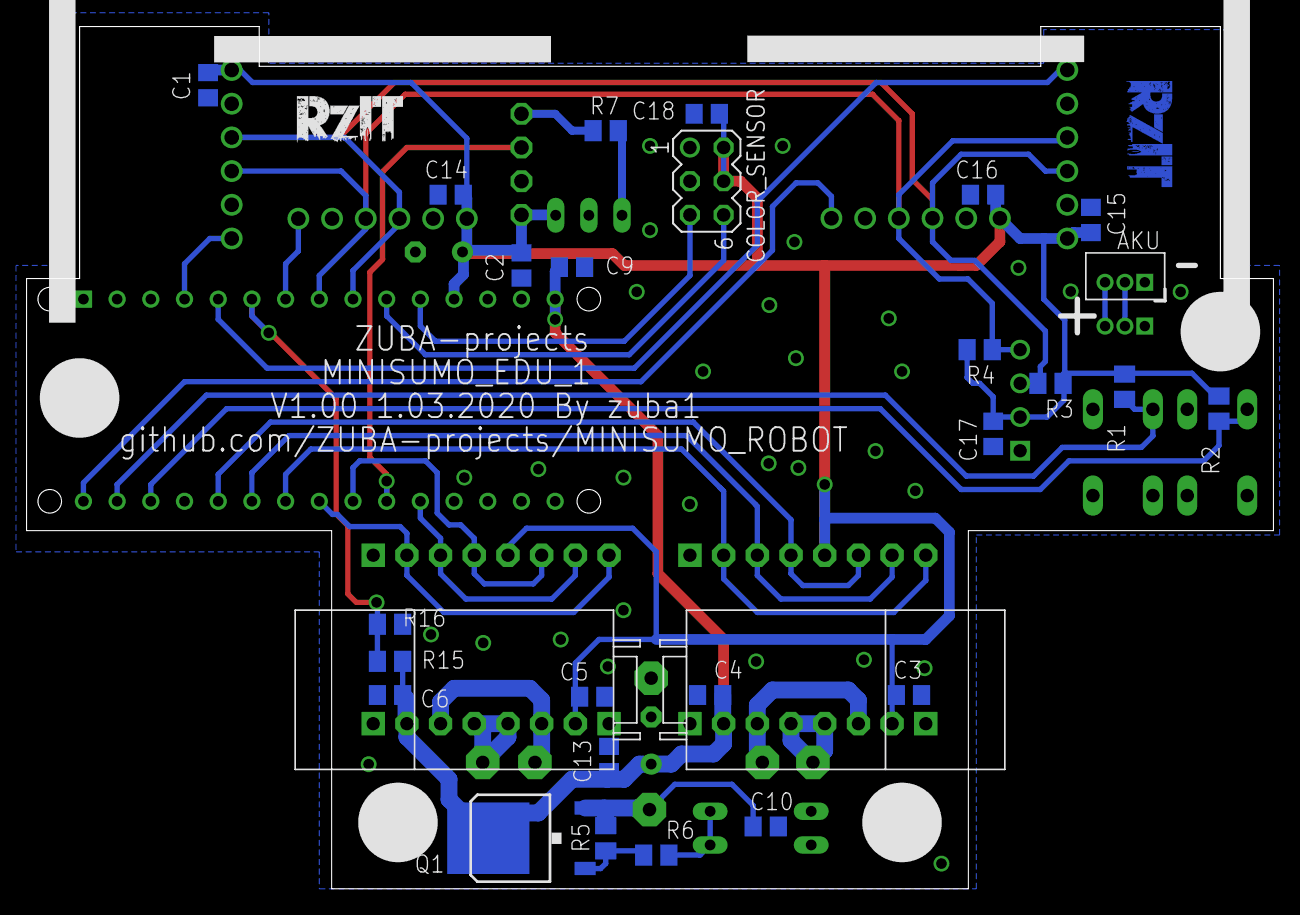
[picture p23: board main.brd from below]

Board: 2 copper layers, 94.0 x 65.0 mm, 52 parts (28 on the bottom side), 32 nets.

Other parts of the board:
U$6, U$7: POLOLU_HP
