ZUBA-projects/MINISUMO_ROBOT/Minisumo_EDU_1/Software/Minisumo_EDU1/MiniOS/vl53l0x/VL53L0X.c

// Most of the functionality of this library is based on the VL53L0X API
// provided by ST (STSW-IMG005), and some of the explanatory comments are quoted
// or paraphrased from the API source code, API user manual (UM2039), and the
// VL53L0X datasheet.

#include "../../hal.h"
#include "VL53L0X.h"

vl53l0x_t * vl53l0xsensor;


// Record the current time to check an upcoming timeout against
#define startTimeout() (vl53l0xsensor->g_timeoutStartMs = hal_millis())

// Check if timeout is enabled (set to nonzero value) and has expired
//#define checkTimeoutExpired() (vl53l0xsensor->g_ioTimeout > 0 && (hal_millis() - vl53l0xsensor->g_timeoutStartMs) > vl53l0xsensor->g_ioTimeout)
#define checkTimeoutExpired() (VL53l0X_TOUT_CFG > 0 && ((hal_millis() - vl53l0xsensor->g_timeoutStartMs) > VL53l0X_TOUT_CFG))

// Decode VCSEL (vertical cavity surface emitting laser) pulse period in PCLKs
// from register value
// based on VL53L0X_decode_vcsel_period()
#define decodeVcselPeriod(reg_val)      (((reg_val) + 1) << 1)

// Encode VCSEL pulse period register value from period in PCLKs
// based on VL53L0X_encode_vcsel_period()
#define encodeVcselPeriod(period_pclks) (((period_pclks) >> 1) - 1)

// Calculate macro period in *nanoseconds* from VCSEL period in PCLKs
// based on VL53L0X_calc_macro_period_ps()
// PLL_period_ps = 1655; macro_period_vclks = 2304
#define calcMacroPeriod(vcsel_period_pclks) ((((uint32_t)2304 * (vcsel_period_pclks) * 1655) + 500) / 1000)


/*
void setAddress(uint8_t new_addr) {
  i2c_writeReg( I2C_SLAVE_DEVICE_ADDRESS, (new_addr) & 0x7F );
  vl53l0xsensor->g_i2cAddr = new_addr<<1;
  i2c_set_reg_instance(vl53l0xsensor->_sclpin,vl53l0xsensor->_sdapin,vl53l0xsensor->g_i2cAddr);
}
*/
/*
uint8_t getAddress() {
  return (uint8_t) (vl53l0xsensor->g_i2cAddr>>1) & 0x7F;
}
*/

// Get reference SPAD (single photon avalanche diode) count and type
// based on VL53L0X_get_info_from_device(),
// but only gets reference SPAD count and type
uint8_t getSpadInfo(uint8_t * count, uint8_t * type_is_aperture)
{
  uint8_t tmp;

  i2c_writeReg(0x80, 0x01);
  i2c_writeReg(0xFF, 0x01);
  i2c_writeReg(0x00, 0x00);

  i2c_writeReg(0xFF, 0x06);
  i2c_writeReg(0x83, i2c_readReg(0x83) | 0x04);
  i2c_writeReg(0xFF, 0x07);
  i2c_writeReg(0x81, 0x01);

  i2c_writeReg(0x80, 0x01);

  i2c_writeReg(0x94, 0x6b);
  i2c_writeReg(0x83, 0x00);
  startTimeout();
  while (i2c_readReg(0x83) == 0x00)
  {
    if (checkTimeoutExpired()) { return 0; }
  }
  i2c_writeReg(0x83, 0x01);
  tmp = i2c_readReg(0x92);

  *count = tmp & 0x7f;
  *type_is_aperture = (tmp >> 7) & 0x01;

  i2c_writeReg(0x81, 0x00);
  i2c_writeReg(0xFF, 0x06);
  i2c_writeReg(0x83, i2c_readReg(0x83)  & ~0x04);
  i2c_writeReg(0xFF, 0x01);
  i2c_writeReg(0x00, 0x01);

  i2c_writeReg(0xFF, 0x00);
  i2c_writeReg(0x80, 0x00);

  return 1;
}



// Convert sequence step timeout from MCLKs to microseconds with given VCSEL period in PCLKs
// based on VL53L0X_calc_timeout_us()
uint32_t timeoutMclksToMicroseconds(uint16_t timeout_period_mclks, uint8_t vcsel_period_pclks)
{
  uint32_t macro_period_ns = calcMacroPeriod(vcsel_period_pclks);

  return ((timeout_period_mclks * macro_period_ns) + (macro_period_ns / 2)) / 1000;
}

// Convert sequence step timeout from microseconds to MCLKs with given VCSEL period in PCLKs
// based on VL53L0X_calc_timeout_mclks()
uint32_t timeoutMicrosecondsToMclks(uint32_t timeout_period_us, uint8_t vcsel_period_pclks)
{
  uint32_t macro_period_ns = calcMacroPeriod(vcsel_period_pclks);

  return (((timeout_period_us * 1000) + (macro_period_ns / 2)) / macro_period_ns);
}


// based on VL53L0X_perform_single_ref_calibration()
uint8_t performSingleRefCalibration(uint8_t vhv_init_byte)
{
  i2c_writeReg(SYSRANGE_START, 0x01 | vhv_init_byte); // VL53L0X_REG_SYSRANGE_MODE_START_STOP

  startTimeout();
  while ((i2c_readReg(RESULT_INTERRUPT_STATUS) & 0x07) == 0)
  {
    if (checkTimeoutExpired()) { return 0; }
  }

  i2c_writeReg(SYSTEM_INTERRUPT_CLEAR, 0x01);

  i2c_writeReg(SYSRANGE_START, 0x00);

  return 1;
}

// Decode sequence step timeout in MCLKs from register value
// based on VL53L0X_decode_timeout()
// Note: the original function returned a uint32_t, but the return value is
// always stored in a uint16_t.
uint16_t decodeTimeout(uint16_t reg_val)
{
  // format: "(LSByte * 2^MSByte) + 1"
  return (uint16_t)((reg_val & 0x00FF) <<
         (uint16_t)((reg_val & 0xFF00) >> 8)) + 1;
}

// Encode sequence step timeout register value from timeout in MCLKs
// based on VL53L0X_encode_timeout()
// Note: the original function took a uint16_t, but the argument passed to it
// is always a uint16_t.
uint16_t encodeTimeout(uint16_t timeout_mclks)
{
  // format: "(LSByte * 2^MSByte) + 1"

  uint32_t ls_byte = 0;
  uint16_t ms_byte = 0;

  if (timeout_mclks > 0)
  {
    ls_byte = timeout_mclks - 1;

    while ((ls_byte & 0xFFFFFF00) > 0)
    {
      ls_byte >>= 1;
      ms_byte++;
    }

    return (ms_byte << 8) | (ls_byte & 0xFF);
  }
  else { return 0; }
}




// Get sequence step enables
// based on VL53L0X_GetSequenceStepEnables()
void getSequenceStepEnables(SequenceStepEnables * enables)
{
  uint8_t sequence_config = i2c_readReg(SYSTEM_SEQUENCE_CONFIG);

  enables->tcc          = (sequence_config >> 4) & 0x1;
  enables->dss          = (sequence_config >> 3) & 0x1;
  enables->msrc         = (sequence_config >> 2) & 0x1;
  enables->pre_range    = (sequence_config >> 6) & 0x1;
  enables->final_range  = (sequence_config >> 7) & 0x1;
}

// Get sequence step timeouts
// based on get_sequence_step_timeout(),
// but gets all timeouts instead of just the requested one, and also stores
// intermediate values
void getSequenceStepTimeouts(SequenceStepEnables const * enables, SequenceStepTimeouts * timeouts)
{
  timeouts->pre_range_vcsel_period_pclks = getVcselPulsePeriod(VcselPeriodPreRange);

  timeouts->msrc_dss_tcc_mclks = i2c_readReg(MSRC_CONFIG_TIMEOUT_MACROP) + 1;
  timeouts->msrc_dss_tcc_us =
    timeoutMclksToMicroseconds(timeouts->msrc_dss_tcc_mclks,
                               timeouts->pre_range_vcsel_period_pclks);

  timeouts->pre_range_mclks =
    decodeTimeout(i2c_readReg16Bit(PRE_RANGE_CONFIG_TIMEOUT_MACROP_HI));
  timeouts->pre_range_us =
    timeoutMclksToMicroseconds(timeouts->pre_range_mclks,
                               timeouts->pre_range_vcsel_period_pclks);

  timeouts->final_range_vcsel_period_pclks = getVcselPulsePeriod(VcselPeriodFinalRange);

  timeouts->final_range_mclks =
    decodeTimeout(i2c_readReg16Bit(FINAL_RANGE_CONFIG_TIMEOUT_MACROP_HI));

  if (enables->pre_range)
  {
    timeouts->final_range_mclks -= timeouts->pre_range_mclks;
  }

  timeouts->final_range_us =
    timeoutMclksToMicroseconds(timeouts->final_range_mclks,
                               timeouts->final_range_vcsel_period_pclks);
}





void preinitVL53L0X(){
	gpioInit(vl53l0xsensor->_gpio0pin, GPIO_OUTPUT);
	gpioInit(vl53l0xsensor->_gpio1pin, GPIO_INPUT);

	gpioSet(vl53l0xsensor->_gpio0pin, 0);

	vl53l0xsensor->g_measTimBudUs=0;
	vl53l0xsensor->g_stopVariable=0;
	vl53l0xsensor->g_timeoutStartMs=0;
	vl53l0xsensor->_sensorstatebus=0;
}



// Initialize sensor using sequence based on VL53L0X_DataInit(),
// VL53L0X_StaticInit(), and VL53L0X_PerformRefCalibration().
// This function does not perform reference SPAD calibration
// (VL53L0X_PerformRefSpadManagement()), since the API user manual says that it
// is performed by ST on the bare modules; it seems like that should work well
// enough unless a cover glass is added.
// If io_2v8 (optional) is 1 or not given, the sensor is configured for 2V8
// mode.
uint8_t initVL53L0X( uint8_t io_2v8 ){
  // VL53L0X_DataInit() begin

	cbi(vl53l0xsensor->_sensorstatebus,VL53L0X_IS_INITED); //clear inited flag
	vl53l0xsensor->_lastrange=0xffff;

	gpioSet(vl53l0xsensor->_gpio0pin, 1); //enable sensor
	hal_delay(100);

	uint8_t tempi2caddr=vl53l0xsensor->g_i2cAddr; //get new addr

	vl53l0xsensor->g_i2cAddr = ADDRESS_DEFAULT;		//set def addr
	vl53l0xsensor->g_i2cAddr= vl53l0xsensor->g_i2cAddr<<1;
	i2c_set_reg_instance(vl53l0xsensor->_sclpin,vl53l0xsensor->_sdapin,vl53l0xsensor->g_i2cAddr);

  // sensor uses 1V8 mode for I/O by default; switch to 2V8 mode if necessary
  if (io_2v8)
  {
    i2c_writeReg(VHV_CONFIG_PAD_SCL_SDA__EXTSUP_HV, i2c_readReg(VHV_CONFIG_PAD_SCL_SDA__EXTSUP_HV) | 0x01); // set bit 0
  }


  if (i2c_readReg(I2C_SLAVE_DEVICE_ADDRESS) != ADDRESS_DEFAULT)
  {
    return 0;
  }

	//set up new i2c addr
	i2c_writeReg( I2C_SLAVE_DEVICE_ADDRESS, (tempi2caddr) & 0x7F );
	vl53l0xsensor->g_i2cAddr=tempi2caddr<<1;
	i2c_set_reg_instance(vl53l0xsensor->_sclpin,vl53l0xsensor->_sdapin,vl53l0xsensor->g_i2cAddr);



  // "Set I2C standard mode"
  i2c_writeReg(0x88, 0x00);

  i2c_writeReg(0x80, 0x01);
  i2c_writeReg(0xFF, 0x01);
  i2c_writeReg(0x00, 0x00);
  vl53l0xsensor->g_stopVariable = i2c_readReg(0x91);
  i2c_writeReg(0x00, 0x01);
  i2c_writeReg(0xFF, 0x00);
  i2c_writeReg(0x80, 0x00);

  // disable SIGNAL_RATE_MSRC (bit 1) and SIGNAL_RATE_PRE_RANGE (bit 4) limit checks
  i2c_writeReg(MSRC_CONFIG_CONTROL, i2c_readReg(MSRC_CONFIG_CONTROL) | 0x12);

  // set final range signal rate limit to 0.25 MCPS (million counts per second)
  setSignalRateLimit(25);

  i2c_writeReg(SYSTEM_SEQUENCE_CONFIG, 0xFF);

  // VL53L0X_DataInit() end

  // VL53L0X_StaticInit() begin

  uint8_t spad_count;
  uint8_t spad_type_is_aperture;
  if (!getSpadInfo(&spad_count, &spad_type_is_aperture)) { return 0; }

  // The SPAD map (RefGoodSpadMap) is read by VL53L0X_get_info_from_device() in
  // the API, but the same data seems to be more easily readable from
  // GLOBAL_CONFIG_SPAD_ENABLES_REF_0 through _6, so read it from there
  uint8_t ref_spad_map[6];
  i2c_readMulti(GLOBAL_CONFIG_SPAD_ENABLES_REF_0, ref_spad_map, 6);

  // -- VL53L0X_set_reference_spads() begin (assume NVM values are valid)

  i2c_writeReg(0xFF, 0x01);
  i2c_writeReg(DYNAMIC_SPAD_REF_EN_START_OFFSET, 0x00);
  i2c_writeReg(DYNAMIC_SPAD_NUM_REQUESTED_REF_SPAD, 0x2C);
  i2c_writeReg(0xFF, 0x00);
  i2c_writeReg(GLOBAL_CONFIG_REF_EN_START_SELECT, 0xB4);

  uint8_t first_spad_to_enable = spad_type_is_aperture ? 12 : 0; // 12 is the first aperture spad
  uint8_t spads_enabled = 0;

  for (uint8_t i = 0; i < 48; i++)
  {
    if (i < first_spad_to_enable || spads_enabled == spad_count)
    {
      // This bit is lower than the first one that should be enabled, or
      // (reference_spad_count) bits have already been enabled, so zero this bit
      ref_spad_map[i / 8] &= ~(1 << (i % 8));
    }
    else if ((ref_spad_map[i / 8] >> (i % 8)) & 0x1)
    {
      spads_enabled++;
    }
  }

  i2c_writeMulti(GLOBAL_CONFIG_SPAD_ENABLES_REF_0, ref_spad_map, 6,0);

  // -- VL53L0X_set_reference_spads() end

  // -- VL53L0X_load_tuning_settings() begin
  // DefaultTuningSettings from vl53l0x_tuning.h



  i2c_writeReg(0xFF, 0x01);
  i2c_writeReg(0x00, 0x00);

  i2c_writeReg(0xFF, 0x00);
  i2c_writeReg(0x09, 0x00);
  i2c_writeReg(0x10, 0x00);
  i2c_writeReg(0x11, 0x00);

  i2c_writeReg(0x24, 0x01);
  i2c_writeReg(0x25, 0xFF);
  i2c_writeReg(0x75, 0x00);

  i2c_writeReg(0xFF, 0x01);
  i2c_writeReg(0x4E, 0x2C);
  i2c_writeReg(0x48, 0x00);
  i2c_writeReg(0x30, 0x20);

  i2c_writeReg(0xFF, 0x00);
  i2c_writeReg(0x30, 0x09);
  i2c_writeReg(0x54, 0x00);
  i2c_writeReg(0x31, 0x04);
  i2c_writeReg(0x32, 0x03);
  i2c_writeReg(0x40, 0x83);
  i2c_writeReg(0x46, 0x25);
  i2c_writeReg(0x60, 0x00);
  i2c_writeReg(0x27, 0x00);
  i2c_writeReg(0x50, 0x06);
  i2c_writeReg(0x51, 0x00);
  i2c_writeReg(0x52, 0x96);
  i2c_writeReg(0x56, 0x08);
  i2c_writeReg(0x57, 0x30);
  i2c_writeReg(0x61, 0x00);
  i2c_writeReg(0x62, 0x00);
  i2c_writeReg(0x64, 0x00);
  i2c_writeReg(0x65, 0x00);
  i2c_writeReg(0x66, 0xA0);

  i2c_writeReg(0xFF, 0x01);
  i2c_writeReg(0x22, 0x32);
  i2c_writeReg(0x47, 0x14);
  i2c_writeReg(0x49, 0xFF);
  i2c_writeReg(0x4A, 0x00);

  i2c_writeReg(0xFF, 0x00);
  i2c_writeReg(0x7A, 0x0A);
  i2c_writeReg(0x7B, 0x00);
  i2c_writeReg(0x78, 0x21);

  i2c_writeReg(0xFF, 0x01);
  i2c_writeReg(0x23, 0x34);
  i2c_writeReg(0x42, 0x00);
  i2c_writeReg(0x44, 0xFF);
  i2c_writeReg(0x45, 0x26);
  i2c_writeReg(0x46, 0x05);
  i2c_writeReg(0x40, 0x40);
  i2c_writeReg(0x0E, 0x06);
  i2c_writeReg(0x20, 0x1A);
  i2c_writeReg(0x43, 0x40);

  i2c_writeReg(0xFF, 0x00);
  i2c_writeReg(0x34, 0x03);
  i2c_writeReg(0x35, 0x44);

  i2c_writeReg(0xFF, 0x01);
  i2c_writeReg(0x31, 0x04);
  i2c_writeReg(0x4B, 0x09);
  i2c_writeReg(0x4C, 0x05);
  i2c_writeReg(0x4D, 0x04);

  i2c_writeReg(0xFF, 0x00);
  i2c_writeReg(0x44, 0x00);
  i2c_writeReg(0x45, 0x20);
  i2c_writeReg(0x47, 0x08);
  i2c_writeReg(0x48, 0x28);
  i2c_writeReg(0x67, 0x00);
  i2c_writeReg(0x70, 0x04);
  i2c_writeReg(0x71, 0x01);
  i2c_writeReg(0x72, 0xFE);
  i2c_writeReg(0x76, 0x00);
  i2c_writeReg(0x77, 0x00);

  i2c_writeReg(0xFF, 0x01);
  i2c_writeReg(0x0D, 0x01);

  i2c_writeReg(0xFF, 0x00);
  i2c_writeReg(0x80, 0x01);
  i2c_writeReg(0x01, 0xF8);

  i2c_writeReg(0xFF, 0x01);
  i2c_writeReg(0x8E, 0x01);
  i2c_writeReg(0x00, 0x01);
  i2c_writeReg(0xFF, 0x00);
  i2c_writeReg(0x80, 0x00);


  // -- VL53L0X_load_tuning_settings() end

  // "Set interrupt config to new sample ready"
  // -- VL53L0X_SetGpioConfig() begin

  i2c_writeReg(SYSTEM_INTERRUPT_CONFIG_GPIO, 0x04);
  i2c_writeReg(GPIO_HV_MUX_ACTIVE_HIGH, i2c_readReg(GPIO_HV_MUX_ACTIVE_HIGH) & ~0x10); // active low
  i2c_writeReg(SYSTEM_INTERRUPT_CLEAR, 0x01);

  // -- VL53L0X_SetGpioConfig() end

  vl53l0xsensor->g_measTimBudUs = getMeasurementTimingBudget();

  // "Disable MSRC and TCC by default"
  // MSRC = Minimum Signal Rate Check
  // TCC = Target CentreCheck
  // -- VL53L0X_SetSequenceStepEnable() begin

  i2c_writeReg(SYSTEM_SEQUENCE_CONFIG, 0xE8);

  // -- VL53L0X_SetSequenceStepEnable() end

  // "Recalculate timing budget"
  setMeasurementTimingBudget(vl53l0xsensor->g_measTimBudUs);

  // VL53L0X_StaticInit() end

  // VL53L0X_PerformRefCalibration() begin (VL53L0X_perform_ref_calibration())

  // -- VL53L0X_perform_vhv_calibration() begin

  i2c_writeReg(SYSTEM_SEQUENCE_CONFIG, 0x01);
  if (!performSingleRefCalibration(0x40)) { return 0; }

  // -- VL53L0X_perform_vhv_calibration() end

  // -- VL53L0X_perform_phase_calibration() begin

  i2c_writeReg(SYSTEM_SEQUENCE_CONFIG, 0x02);
  if (!performSingleRefCalibration(0x00)) { return 0; }

  // -- VL53L0X_perform_phase_calibration() end

  // "restore the previous Sequence Config"
  i2c_writeReg(SYSTEM_SEQUENCE_CONFIG, 0xE8);

  // VL53L0X_PerformRefCalibration() end



  return 1;
}

// Set the return signal rate limit check value in units of MCPS (mega counts
// per second). "This represents the amplitude of the signal reflected from the
// target and detected by the device"; setting this limit presumably determines
// the minimum measurement necessary for the sensor to report a valid reading.
// Setting a lower limit increases the potential range of the sensor but also
// seems to increase the likelihood of getting an inaccurate reading because of
// unwanted reflections from objects other than the intended target.
// Defaults to 0.25 MCPS as initialized by the ST API and this library.
/*
uint8_t setSignalRateLimit(float limit_Mcps)
{
  if (limit_Mcps < 0 || limit_Mcps > 511.99) { return 0; }

  // Q9.7 fixed point format (9 integer bits, 7 fractional bits)
  i2c_writeReg16Bit(FINAL_RANGE_CONFIG_MIN_COUNT_RATE_RTN_LIMIT, limit_Mcps * (1 << 7));
  return 1;
}

*/

uint8_t setSignalRateLimit(uint32_t limit_Mcps)
{
  if (limit_Mcps < 0 || limit_Mcps > 51199) { return 0; }

  // Q9.7 fixed point format (9 integer bits, 7 fractional bits)

    limit_Mcps=limit_Mcps*128;
    limit_Mcps=limit_Mcps/100;

    i2c_writeReg16Bit(FINAL_RANGE_CONFIG_MIN_COUNT_RATE_RTN_LIMIT, limit_Mcps);
  return 1;
}



/*
// Get the return signal rate limit check value in MCPS
float getSignalRateLimit(void)
{
  return (float)i2c_readReg16Bit(FINAL_RANGE_CONFIG_MIN_COUNT_RATE_RTN_LIMIT) / (1 << 7);
}
*/
// Set the measurement timing budget in microseconds, which is the time allowed
// for one measurement; the ST API and this library take care of splitting the
// timing budget among the sub-steps in the ranging sequence. A longer timing
// budget allows for more accurate measurements. Increasing the budget by a
// factor of N decreases the range measurement standard deviation by a factor of
// sqrt(N). Defaults to about 33 milliseconds; the minimum is 20 ms.
// based on VL53L0X_set_measurement_timing_budget_micro_seconds()
uint8_t setMeasurementTimingBudget(uint32_t budget_us)
{
  SequenceStepEnables enables;
  SequenceStepTimeouts timeouts;

  uint16_t const StartOverhead      = 1320; // note that this is different than the value in get_
  uint16_t const EndOverhead        = 960;
  uint16_t const MsrcOverhead       = 660;
  uint16_t const TccOverhead        = 590;
  uint16_t const DssOverhead        = 690;
  uint16_t const PreRangeOverhead   = 660;
  uint16_t const FinalRangeOverhead = 550;

  uint32_t const MinTimingBudget = 20000;

  if (budget_us < MinTimingBudget) { return 0; }

  uint32_t used_budget_us = StartOverhead + EndOverhead;

  getSequenceStepEnables(&enables);
  getSequenceStepTimeouts(&enables, &timeouts);

  if (enables.tcc)
  {
    used_budget_us += (timeouts.msrc_dss_tcc_us + TccOverhead);
  }

  if (enables.dss)
  {
    used_budget_us += 2 * (timeouts.msrc_dss_tcc_us + DssOverhead);
  }
  else if (enables.msrc)
  {
    used_budget_us += (timeouts.msrc_dss_tcc_us + MsrcOverhead);
  }

  if (enables.pre_range)
  {
    used_budget_us += (timeouts.pre_range_us + PreRangeOverhead);
  }

  if (enables.final_range)
  {
    used_budget_us += FinalRangeOverhead;

    // "Note that the final range timeout is determined by the timing
    // budget and the sum of all other timeouts within the sequence.
    // If there is no room for the final range timeout, then an error
    // will be set. Otherwise the remaining time will be applied to
    // the final range."

    if (used_budget_us > budget_us)
    {
      // "Requested timeout too big."
      return 0;
    }

    uint32_t final_range_timeout_us = budget_us - used_budget_us;

    // set_sequence_step_timeout() begin
    // (SequenceStepId == VL53L0X_SEQUENCESTEP_FINAL_RANGE)

    // "For the final range timeout, the pre-range timeout
    //  must be added. To do this both final and pre-range
    //  timeouts must be expressed in macro periods MClks
    //  because they have different vcsel periods."

    uint16_t final_range_timeout_mclks =
      timeoutMicrosecondsToMclks(final_range_timeout_us,
                                 timeouts.final_range_vcsel_period_pclks);

    if (enables.pre_range)
    {
      final_range_timeout_mclks += timeouts.pre_range_mclks;
    }

    i2c_writeReg16Bit(FINAL_RANGE_CONFIG_TIMEOUT_MACROP_HI,
      encodeTimeout(final_range_timeout_mclks));

    // set_sequence_step_timeout() end

    vl53l0xsensor->g_measTimBudUs = budget_us; // store for internal reuse
  }
  return 1;
}

// Get the measurement timing budget in microseconds
// based on VL53L0X_get_measurement_timing_budget_micro_seconds()
// in us
uint32_t getMeasurementTimingBudget(void)
{
  SequenceStepEnables enables;
  SequenceStepTimeouts timeouts;

  uint16_t const StartOverhead     = 1910; // note that this is different than the value in set_
  uint16_t const EndOverhead        = 960;
  uint16_t const MsrcOverhead       = 660;
  uint16_t const TccOverhead        = 590;
  uint16_t const DssOverhead        = 690;
  uint16_t const PreRangeOverhead   = 660;
  uint16_t const FinalRangeOverhead = 550;

  // "Start and end overhead times always present"
  uint32_t budget_us = StartOverhead + EndOverhead;

  getSequenceStepEnables(&enables);
  getSequenceStepTimeouts(&enables, &timeouts);

  if (enables.tcc)
  {
    budget_us += (timeouts.msrc_dss_tcc_us + TccOverhead);
  }

  if (enables.dss)
  {
    budget_us += 2 * (timeouts.msrc_dss_tcc_us + DssOverhead);
  }
  else if (enables.msrc)
  {
    budget_us += (timeouts.msrc_dss_tcc_us + MsrcOverhead);
  }

  if (enables.pre_range)
  {
    budget_us += (timeouts.pre_range_us + PreRangeOverhead);
  }

  if (enables.final_range)
  {
    budget_us += (timeouts.final_range_us + FinalRangeOverhead);
  }

  vl53l0xsensor->g_measTimBudUs = budget_us; // store for internal reuse
  return budget_us;
}

// Set the VCSEL (vertical cavity surface emitting laser) pulse period for the
// given period type (pre-range or final range) to the given value in PCLKs.
// Longer periods seem to increase the potential range of the sensor.
// Valid values are (even numbers only):
//  pre:  12 to 18 (initialized default: 14)
//  final: 8 to 14 (initialized default: 10)
// based on VL53L0X_set_vcsel_pulse_period()
uint8_t setVcselPulsePeriod(vcselPeriodType type, uint8_t period_pclks)
{
  uint8_t vcsel_period_reg = encodeVcselPeriod(period_pclks);

  SequenceStepEnables enables;
  SequenceStepTimeouts timeouts;

  getSequenceStepEnables(&enables);
  getSequenceStepTimeouts(&enables, &timeouts);

  // "Apply specific settings for the requested clock period"
  // "Re-calculate and apply timeouts, in macro periods"

  // "When the VCSEL period for the pre or final range is changed,
  // the corresponding timeout must be read from the device using
  // the current VCSEL period, then the new VCSEL period can be
  // applied. The timeout then must be written back to the device
  // using the new VCSEL period.
  //
  // For the MSRC timeout, the same applies - this timeout being
  // dependant on the pre-range vcsel period."


  if (type == VcselPeriodPreRange)
  {
    // "Set phase check limits"
    switch (period_pclks)
    {
      case 12:
        i2c_writeReg(PRE_RANGE_CONFIG_VALID_PHASE_HIGH, 0x18);
        break;

      case 14:
        i2c_writeReg(PRE_RANGE_CONFIG_VALID_PHASE_HIGH, 0x30);
        break;

      case 16:
        i2c_writeReg(PRE_RANGE_CONFIG_VALID_PHASE_HIGH, 0x40);
        break;

      case 18:
        i2c_writeReg(PRE_RANGE_CONFIG_VALID_PHASE_HIGH, 0x50);
        break;

      default:
        // invalid period
        return 0;
    }
    i2c_writeReg(PRE_RANGE_CONFIG_VALID_PHASE_LOW, 0x08);

    // apply new VCSEL period
    i2c_writeReg(PRE_RANGE_CONFIG_VCSEL_PERIOD, vcsel_period_reg);

    // update timeouts

    // set_sequence_step_timeout() begin
    // (SequenceStepId == VL53L0X_SEQUENCESTEP_PRE_RANGE)

    uint16_t new_pre_range_timeout_mclks =
      timeoutMicrosecondsToMclks(timeouts.pre_range_us, period_pclks);

    i2c_writeReg16Bit(PRE_RANGE_CONFIG_TIMEOUT_MACROP_HI,
      encodeTimeout(new_pre_range_timeout_mclks));

    // set_sequence_step_timeout() end

    // set_sequence_step_timeout() begin
    // (SequenceStepId == VL53L0X_SEQUENCESTEP_MSRC)

    uint16_t new_msrc_timeout_mclks =
      timeoutMicrosecondsToMclks(timeouts.msrc_dss_tcc_us, period_pclks);

    i2c_writeReg(MSRC_CONFIG_TIMEOUT_MACROP,
      (new_msrc_timeout_mclks > 256) ? 255 : (new_msrc_timeout_mclks - 1));

    // set_sequence_step_timeout() end
  }
  else if (type == VcselPeriodFinalRange)
  {
    switch (period_pclks)
    {
      case 8:
        i2c_writeReg(FINAL_RANGE_CONFIG_VALID_PHASE_HIGH, 0x10);
        i2c_writeReg(FINAL_RANGE_CONFIG_VALID_PHASE_LOW,  0x08);
        i2c_writeReg(GLOBAL_CONFIG_VCSEL_WIDTH, 0x02);
        i2c_writeReg(ALGO_PHASECAL_CONFIG_TIMEOUT, 0x0C);
        i2c_writeReg(0xFF, 0x01);
        i2c_writeReg(ALGO_PHASECAL_LIM, 0x30);
        i2c_writeReg(0xFF, 0x00);
        break;

      case 10:
        i2c_writeReg(FINAL_RANGE_CONFIG_VALID_PHASE_HIGH, 0x28);
        i2c_writeReg(FINAL_RANGE_CONFIG_VALID_PHASE_LOW,  0x08);
        i2c_writeReg(GLOBAL_CONFIG_VCSEL_WIDTH, 0x03);
        i2c_writeReg(ALGO_PHASECAL_CONFIG_TIMEOUT, 0x09);
        i2c_writeReg(0xFF, 0x01);
        i2c_writeReg(ALGO_PHASECAL_LIM, 0x20);
        i2c_writeReg(0xFF, 0x00);
        break;

      case 12:
        i2c_writeReg(FINAL_RANGE_CONFIG_VALID_PHASE_HIGH, 0x38);
        i2c_writeReg(FINAL_RANGE_CONFIG_VALID_PHASE_LOW,  0x08);
        i2c_writeReg(GLOBAL_CONFIG_VCSEL_WIDTH, 0x03);
        i2c_writeReg(ALGO_PHASECAL_CONFIG_TIMEOUT, 0x08);
        i2c_writeReg(0xFF, 0x01);
        i2c_writeReg(ALGO_PHASECAL_LIM, 0x20);
        i2c_writeReg(0xFF, 0x00);
        break;

      case 14:
        i2c_writeReg(FINAL_RANGE_CONFIG_VALID_PHASE_HIGH, 0x48);
        i2c_writeReg(FINAL_RANGE_CONFIG_VALID_PHASE_LOW,  0x08);
        i2c_writeReg(GLOBAL_CONFIG_VCSEL_WIDTH, 0x03);
        i2c_writeReg(ALGO_PHASECAL_CONFIG_TIMEOUT, 0x07);
        i2c_writeReg(0xFF, 0x01);
        i2c_writeReg(ALGO_PHASECAL_LIM, 0x20);
        i2c_writeReg(0xFF, 0x00);
        break;

      default:
        // invalid period
        return 0;
    }

    // apply new VCSEL period
    i2c_writeReg(FINAL_RANGE_CONFIG_VCSEL_PERIOD, vcsel_period_reg);

    // update timeouts

    // set_sequence_step_timeout() begin
    // (SequenceStepId == VL53L0X_SEQUENCESTEP_FINAL_RANGE)

    // "For the final range timeout, the pre-range timeout
    //  must be added. To do this both final and pre-range
    //  timeouts must be expressed in macro periods MClks
    //  because they have different vcsel periods."

    uint16_t new_final_range_timeout_mclks =
      timeoutMicrosecondsToMclks(timeouts.final_range_us, period_pclks);

    if (enables.pre_range)
    {
      new_final_range_timeout_mclks += timeouts.pre_range_mclks;
    }

    i2c_writeReg16Bit(FINAL_RANGE_CONFIG_TIMEOUT_MACROP_HI,
      encodeTimeout(new_final_range_timeout_mclks));

    // set_sequence_step_timeout end
  }
  else
  {
    // invalid type
    return 0;
  }

  // "Finally, the timing budget must be re-applied"

  setMeasurementTimingBudget(vl53l0xsensor->g_measTimBudUs);

  // "Perform the phase calibration. This is needed after changing on vcsel period."
  // VL53L0X_perform_phase_calibration() begin

  uint8_t sequence_config = i2c_readReg(SYSTEM_SEQUENCE_CONFIG);
  i2c_writeReg(SYSTEM_SEQUENCE_CONFIG, 0x02);
  performSingleRefCalibration(0x0);
  i2c_writeReg(SYSTEM_SEQUENCE_CONFIG, sequence_config);

  // VL53L0X_perform_phase_calibration() end

  return 1;
}

// Get the VCSEL pulse period in PCLKs for the given period type.
// based on VL53L0X_get_vcsel_pulse_period()
uint8_t getVcselPulsePeriod(vcselPeriodType type)
{
  if (type == VcselPeriodPreRange)
  {
    return decodeVcselPeriod(i2c_readReg(PRE_RANGE_CONFIG_VCSEL_PERIOD));
  }
  else if (type == VcselPeriodFinalRange)
  {
    return decodeVcselPeriod(i2c_readReg(FINAL_RANGE_CONFIG_VCSEL_PERIOD));
  }
  else { return 255; }
}

// Start continuous ranging measurements. If period_ms (optional) is 0 or not
// given, continuous back-to-back mode is used (the sensor takes measurements as
// often as possible); otherwise, continuous timed mode is used, with the given
// inter-measurement period in milliseconds determining how often the sensor
// takes a measurement.
// based on VL53L0X_StartMeasurement()
void startContinuous(uint32_t period_ms)
{
  i2c_writeReg(0x80, 0x01);
  i2c_writeReg(0xFF, 0x01);
  i2c_writeReg(0x00, 0x00);
  i2c_writeReg(0x91, vl53l0xsensor->g_stopVariable);
  i2c_writeReg(0x00, 0x01);
  i2c_writeReg(0xFF, 0x00);
  i2c_writeReg(0x80, 0x00);

  if (period_ms != 0)
  {
    // continuous timed mode

    // VL53L0X_SetInterMeasurementPeriodMilliSeconds() begin

    uint16_t osc_calibrate_val = i2c_readReg16Bit(OSC_CALIBRATE_VAL);

    if (osc_calibrate_val != 0)
    {
      period_ms *= osc_calibrate_val;
    }

    i2c_writeReg32Bit(SYSTEM_INTERMEASUREMENT_PERIOD, period_ms);

    // VL53L0X_SetInterMeasurementPeriodMilliSeconds() end

    i2c_writeReg(SYSRANGE_START, 0x04); // VL53L0X_REG_SYSRANGE_MODE_TIMED
  }
  else
  {
    // continuous back-to-back mode
    i2c_writeReg(SYSRANGE_START, 0x02); // VL53L0X_REG_SYSRANGE_MODE_BACKTOBACK
  }
}

// Stop continuous measurements
// based on VL53L0X_StopMeasurement()
/*
void stopContinuous(void)
{
  i2c_writeReg(SYSRANGE_START, 0x01); // VL53L0X_REG_SYSRANGE_MODE_SINGLESHOT

  i2c_writeReg(0xFF, 0x01);
  i2c_writeReg(0x00, 0x00);
  i2c_writeReg(0x91, 0x00);
  i2c_writeReg(0x00, 0x01);
  i2c_writeReg(0xFF, 0x00);
}*/

// Returns a range reading in millimeters when continuous mode is active
// (readRangeSingleMillimeters() also calls this function after starting a
// single-shot range measurement)
// extraStats provides additional info for this measurment. Set to 0 if not needed.
/*
uint16_t readRangeContinuousMillimeters( statInfo_t *extraStats ) {
  uint8_t tempBuffer[12];
  uint16_t temp;

  startTimeout();
  while ((i2c_readReg(RESULT_INTERRUPT_STATUS) & 0x07) == 0) {
    if (checkTimeoutExpired())
    {
      return 65535;
    }
  }

  if( extraStats == 0 ){
    // assumptions: Linearity Corrective Gain is 1000 (default);
    // fractional ranging is not enabled
    temp = i2c_readReg16Bit(RESULT_RANGE_STATUS + 10);
  } else {
    // Register map starting at 0x14
    //     0  1  2  3  4  5  6  7  8  9  A  B  C  D  E  F
    //    5A 06 BC 04 00 85 00 38 00 19 06 B6 00 00 00 00
    //   0: Ranging status, uint8_t
    //   1: ???
    // 3,2: Effective SPAD return count, uint16_t, fixpoint8.8
    //   4: 0 ?
    //   5: ???
    // 6,7: signal count rate [mcps], uint16_t, fixpoint9.7
    // 9,8: AmbientRateRtnMegaCps  [mcps], uint16_t, fixpoimt9.7
    // A,B: uncorrected distance [mm], uint16_t
    readMulti(0x14, tempBuffer, 12);
    extraStats->rangeStatus =  tempBuffer[0x00]>>3;
    extraStats->spadCnt     = (tempBuffer[0x02]<<8) | tempBuffer[0x03];
    extraStats->signalCnt   = (tempBuffer[0x06]<<8) | tempBuffer[0x07];
    extraStats->ambientCnt  = (tempBuffer[0x08]<<8) | tempBuffer[0x09];    
    temp                    = (tempBuffer[0x0A]<<8) | tempBuffer[0x0B];
    extraStats->rawDistance = temp;
  }
  i2c_writeReg(SYSTEM_INTERRUPT_CLEAR, 0x01);
  return temp;
}
*/


uint16_t readRangeContinousSensor(){

	uint16_t temp = i2c_readReg16Bit(RESULT_RANGE_STATUS + 10);
  	i2c_writeReg(SYSTEM_INTERRUPT_CLEAR, 0x01);
  	startTimeout();
  	//if(temp>vl53l0xsensor->_maxrange) temp=vl53l0xsensor->_maxrange+1; //normalize value to software defined max distance.
  	//return distance from 0mm to max defined _maxrange
  	//in any other values bigger than max range return _maxrange+1
  	//max range is not used in this level of app. is moved to minios file in comparesenosr method
	return temp;
}



uint8_t checkRangeContinousSensor(){

	if(bitRead(vl53l0xsensor->_sensorstatebus,VL53L0X_IS_INITED) ==0) return vl53l0xsensor->_sensorstatebus;

	//check timeout
    if (checkTimeoutExpired())
    {
    	//reload sensor
    	i2c_writeReg(SYSTEM_INTERRUPT_CLEAR, 0x01);
    	startTimeout();

    	sbi(vl53l0xsensor->_sensorstatebus,VL53L0X_TOUTERR); //set is timeout err flag

    	vl53l0xsensor->_errcount++;

		if(vl53l0xsensor->_errcount>MAX_VL53L0X_ERR_COUNTS){
			vl53l0xsensor->_errcount=0;
			cbi(vl53l0xsensor->_sensorstatebus,VL53L0X_IS_INITED); //clear is inited flag
			vl53l0xsensor->_lastrange=0xFFFF;
		}

      	return vl53l0xsensor->_sensorstatebus;

    }else{
    	cbi(vl53l0xsensor->_sensorstatebus,VL53L0X_TOUTERR); //clear is timeout err flag
    }

	if((i2c_readReg(RESULT_INTERRUPT_STATUS) & 0x07) != 0){

		sbi(vl53l0xsensor->_sensorstatebus,VL53L0X_DONE); //set is done flag
		vl53l0xsensor->_lastrange=readRangeContinousSensor();
		vl53l0xsensor->_errcount=0;

	}/*else{
		cbi(vl53l0xsensor->_sensorstatebus,VL53L0X_DONE); //clear is done flag
	}*/

	return vl53l0xsensor->_sensorstatebus;
}


// Performs a single-shot range measurement and returns the reading in
// millimeters
// based on VL53L0X_PerformSingleRangingMeasurement()
// extraStats provides additional info for this measurment. Set to 0 if not needed.
/*
uint16_t readRangeSingleMillimeters( statInfo_t *extraStats ) {
  i2c_writeReg(0x80, 0x01);
  i2c_writeReg(0xFF, 0x01);
  i2c_writeReg(0x00, 0x00);
  i2c_writeReg(0x91, vl53l0xsensor->g_stopVariable);
  i2c_writeReg(0x00, 0x01);
  i2c_writeReg(0xFF, 0x00);
  i2c_writeReg(0x80, 0x00);
  i2c_writeReg(SYSRANGE_START, 0x01);
  // "Wait until start bit has been cleared"
  startTimeout();
  while (i2c_readReg(SYSRANGE_START) & 0x01){
    if (checkTimeoutExpired()){
      return 65535;
    }
  }
  return readRangeContinuousMillimeters( extraStats );
}
*/
void setvl53l0xinstance(vl53l0x_t * _vl53l0xsensor){
	vl53l0xsensor=_vl53l0xsensor;
	i2c_set_reg_instance(vl53l0xsensor->_sclpin,vl53l0xsensor->_sdapin,vl53l0xsensor->g_i2cAddr);
}

void initVL53L0X_to_continous(rangesensorconfig_t *_cfg){

	if(initVL53L0X(1)){
		// lower the return signal rate limit (default is 0.25 MCPS)
		setSignalRateLimit(_cfg->_SignalRateLimit);	//0.1 as 10
		// increase laser pulse periods (defaults are 14 and 10 PCLKs)
		setVcselPulsePeriod(VcselPeriodPreRange, _cfg->_VcselPulsePeriodPre);	//18
		setVcselPulsePeriod(VcselPeriodFinalRange, _cfg->_VcselPulsePeriodFinal);	//14
		setMeasurementTimingBudget(  _cfg->_timmingbudget * 1000UL );		// integrate over x ms per measurement

		startContinuous(_cfg->_timmingpetroid);
		sbi(vl53l0xsensor->_sensorstatebus,VL53L0X_IS_INITED); //set is inited flag
	}
}
