ZUBA-projects/MINISUMO_ROBOT/(commit log)

2020-02-19 BETA Version of Minisumo robot EDU_1. Bad arduino 3d model, need some changes in pcb and some bugs in 3d model
    [Minisumo_EDU_1_BOM.xlsx, main.brd, main.sch]
2020-03-08 V1.0 No software
    [Minisumo_Body.stl, Minisumo_EDU_1_BOM.xlsx, Wheel_30x25.f3d, holedr_wheel.stl, main.brd, main.sch, wheel.stl]
2020-03-10 Added new bom. Fixed mechanical problem.
    [Minisumo_EDU_1_BOM.xlsx]
2020-04-05 Test of circuit. Oled, ADC and TOF sensor powered by Arduino Libs
2020-04-18 Added new oled and vl53l0x sensor lib's. Some Arduino core code. Temporary two code versions in testing (Arduino and my_HAL version).
2020-06-08 Final 3d model V1, final pcb model V1.00, Software version 0.32 (uncomplete -only for testing). New files organization
    [Minisumo_Body.stl, Minisumo_EDU_1_BOM.xlsx, Wheel_30x25.f3d, holedr_wheel.stl, main.brd, main.sch, wheel.stl]
